tachin-r/Pyranometer_Over_engineering/Report_doc/image/thumb_power_switching.jpg

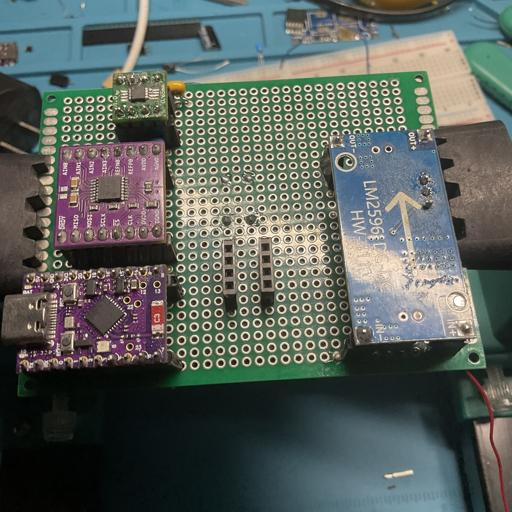
Report_doc/image/thumb_power_switching.jpg
