tachin-r/Pyranometer_Over_engineering/Report_doc/image/breadboard_real_photo.jpg

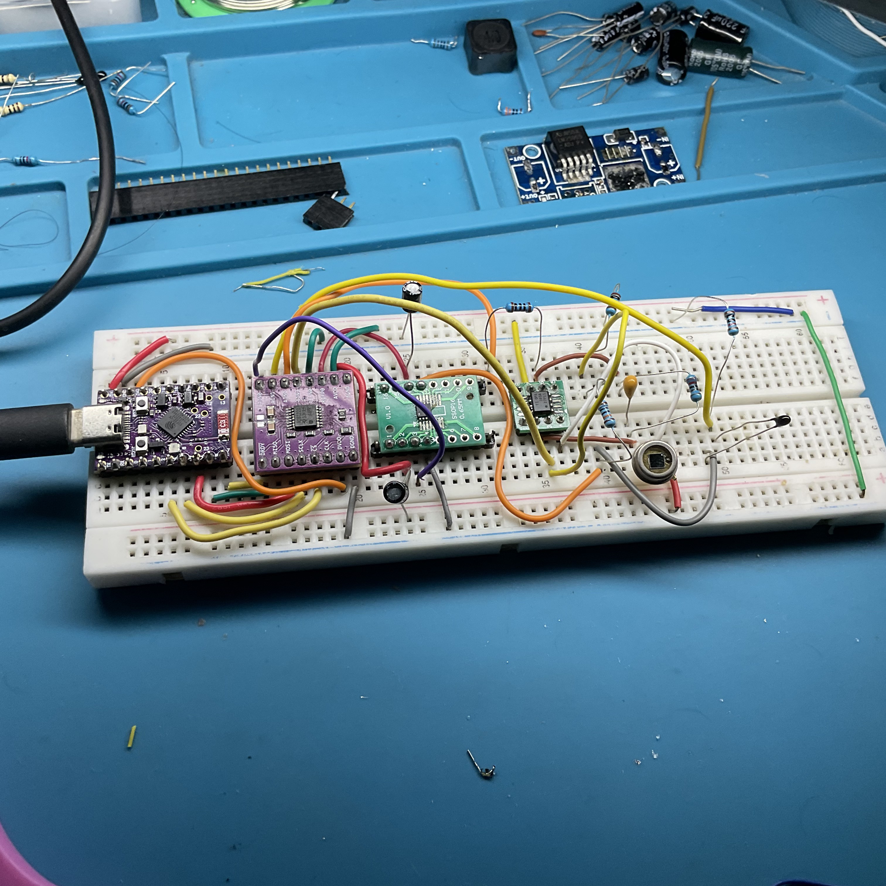
Report_doc/image/breadboard_real_photo.jpg
