tachin-r/Pyranometer_Over_engineering/README.md

# Pyranometer Over-engineering ☀️⚡

Modular High-Precision Pyranometer KiCad Hardware Project.

---

## 📑 Project Structure & Interactive Online Viewers

Explore the schematics and PCB layouts interactively directly in your browser powered by **KiCanvas** (no installation required):

| Board / Module | Description | Interactive Project (Schematic + PCB) | Schematic Only | PCB Only |
| :--- | :--- | :---: | :---: | :---: |
| **L1_Analog** | Analog Front-End & Sensor Interface | [🚀 Open L1 Board](https://kicanvas.org/?github=https://github.com/tachin-r/Pyranometer_Over_engineering/tree/main/L1_Analog) | [🔍 Schematic](https://kicanvas.org/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) | [🔍 PCB](https://kicanvas.org/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) |
| **L2_MCU** | Microcontroller Processing Board | [🚀 Open L2 Board](https://kicanvas.org/?github=https://github.com/tachin-r/Pyranometer_Over_engineering/tree/main/L2_MCU) | [🔍 Schematic](https://kicanvas.org/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) | [🔍 PCB](https://kicanvas.org/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) |
| **L3_Switching** | Power Management & Switching Regulators | [🚀 Open L3 Board](https://kicanvas.org/?github=https://github.com/tachin-r/Pyranometer_Over_engineering/tree/main/L3_Switching) | [🔍 Schematic](https://kicanvas.org/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) | [🔍 PCB](https://kicanvas.org/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) |
| **LM2596 HW-411** | Reverse-Engineered Buck Converter Module | [🚀 Open LM2596](https://kicanvas.org/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) | [🔍 Schematic](https://kicanvas.org/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) | [🔍 PCB](https://kicanvas.org/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) |

---

## 🛠️ Boards Overview

### 1. `L1_Analog` (Sensor Front-End)
* Precision Analog Signal Conditioning stage designed for low-noise measurement of solar irradiance sensor signals (Pyranometer Thermopile / Photodiode).

### 2. `L2_MCU` (Processing & Control)
* Primary microcontroller board responsible for high-resolution ADC sampling, calibration algorithms, digital filtering, and telemetry communication.

### 3. `L3_Switching` (Power Distribution)
* Power supply unit (PSU) providing efficient switching regulation, clean power rail generation, and noise filtering for sensitive analog circuitry.

### 4. `reverse_component/LM2596_HW411`
* Reverse-engineered KiCad schematic and PCB layout of the common LM2596 HW-411 DC-DC step-down converter module, used for reference, testing, and validation.

---

## 🚀 Working with KiCad

This project is organized as a **modular multi-board system**:
* Each sub-directory contains its own standalone KiCad project file (`.kicad_pro`).
* To view or edit a board, open the corresponding `.kicad_pro` file inside its respective directory.

---

## 🔬 Capstone Documentation & Laboratory Calibration

* **[☀️ Solar Simulator Preparation & Contact Guide](file:///c:/Users/usEr/Documents/KiCad/10.0/projects/Pyranometer_Over_engineering/Report_doc/SOLAR_SIMULATOR_GUIDE.md)**: Contact templates, technical phone checklists, and procedures for using the **Solar Light XPS-300** at ATTAC / Nano Central Lab (Building 55, 3rd Floor).
* **[📷 Perfboard Photo & Figure Insertion Guide](file:///c:/Users/usEr/Documents/KiCad/10.0/projects/Pyranometer_Over_engineering/Report_doc/PHOTO_GUIDE_PERFBOARD.md)**: Complete image checklist and tips for inserting hardware photos into the report.
* **[📄 Capstone Progress Report V2 (.docx)](file:///c:/Users/usEr/Documents/KiCad/10.0/projects/Pyranometer_Over_engineering/Report_doc/69_IoT_Project1_Report_V2.docx)**: Official 5-chapter thesis report draft formatted to KMITL guidelines.
