tachin-r/Pyranometer_Over_engineering/SMD_EP_Adapter_Business_Plan.md

# 💡 แผนธุรกิจและการพัฒนาสินค้า: บอร์ดแปลงขา SMD แบบมีแผ่นระบายความร้อน/กราวด์ใต้ท้องชิป (Precision SMD-EP Breakout Adapter Series)

> **ที่มาของไอเดีย (Real-World Pain Point):**
> จากการทำโปรเจกต์ **Engineering Pyranometer** แล้วพบปัญหาคลาสสิกเมื่อนำชิปเกรดเครื่องมือวัดของ Texas Instruments (`TPS7A4901DGNR` ตัวถัง `MSOP-8 PowerPAD`) ไปวางบนบอร์ดแปลงขา `MSOP-8` ทั่วไปที่มีขายในไทย ซึ่ง **ไม่มีแผ่นทองแดงตรงกลาง (Exposed Pad / Pin 9)** ส่งผลให้กราวด์ของฐานซิลิคอน (Die Substrate) ลอย และแรงดันอ้างอิงภายในตกเหลือครึ่งเดียว (`0.625 V` แทนที่จะเป็น `1.185 V`) ครั้นจะสั่งซื้อบอร์ดแปลงขาเฉพาะทางจากต่างประเทศ (เช่น Chip Quik / Proto-Advantage) ก็มีราคาสูงถึงชิ้นละ **230–250 บาท ($6.69)** ในขณะที่ตลาดในไทยยังไม่มีใครทำบอร์ดแปลงขาตระกูล `Exposed Pad (EP)` ออกมาขายเลย

---

## 🎯 1. จุดขายหลักที่เหนือกว่าบอร์ดทั่วไปในตลาด (Unique Selling Points)

1. **บัดกรีแผ่นใต้ท้องชิป (`EP` / `PowerPAD`) ได้ด้วยหัวแร้งธรรมดา (No Hot-Air Required):**
   * ออกแบบรูชุบทองแดงทะลุขนาดใหญ่ (**Center Solder Via Ø `1.0 – 1.2 mm`**) ตรงกลางแผ่น `Exposed Pad`
   * ผู้ใช้เพียงวางชิปและบัดกรีขารอบนอกตามปกติ แล้วพลิกด้านหลังบอร์ดเอาหัวแร้งจี้เติมตะกั่วลงในรูตรงกลาง ตะกั่วจะซึมขึ้นไปยึดติดกับท้องชิป (ขา 9) แน่นสนิทโดยไม่ต้องใช้เครื่องเป่าลมร้อน
2. **มี Solder Jumper เลือกต่อลง `GND` ได้ในหยดเดียว:**
   * ด้านหลังบอร์ดมีจุดแตะตะกั่วเชื่อมแผ่น `EP` เข้ากับขามาตรฐานที่เป็น `GND` (เช่น ขา 4 สำหรับตระกูล LDO/Op-Amp) หรือจะแยกออกเป็นขา Pin ที่ 9 สำหรับเสียบลงเบรดบอร์ดโดยตรงก็ได้
3. **มีจุดวางตัวเก็บประจุ Bypass (`0805`) ชิดขาชิปบนตัวบอร์ดแปลงขา:**
   * แก้ปัญหาสายยาวบนเบรดบอร์ดที่ทำให้วงจรความละเอียดสูงเกิดการแกว่ง (Oscillation) หรือสัญญาณรบกวนสูง โดยเตรียม Pad ขนาด `0805` ไว้ชิดขาไฟเลี้ยง (`IN`/`VDD` และ `OUT` เทียบกับแผ่น `EP GND`)
4. **ผิวชุบทอง (`ENIG` - Electroless Nickel Immersion Gold) หรือสีบอร์ดเกรดพรีเมียม (สีดำด้าน / สีน้ำเงินเข้ม):**
   * ช่วยให้แผ่นเรียบสนิท วางชิปที่มีระยะห่างขาแคบ (`0.5 mm` – `0.65 mm`) ได้ง่าย ไม่กระดก และเก็บไว้ได้นานโดยไม่ขึ้นออกไซด์

---

## 📦 2. รายการสินค้าที่ควรทำออกขาย (Product Lineup — 5 รุ่นยอดฮิต)

| ลำดับ | ชื่อรุ่นบอร์ดแปลงขา | ตัวถังชิปที่รองรับ | ตัวอย่างชิปยอดนิยมที่ใช้ตัวถังนี้ | ราคาขายแนะนำ (บาท/ชิ้น) |
| :---: | :--- | :--- | :--- | :---: |
| **1** | **MSOP-8-EP / HVSSOP-8 Pro Adapter** | `MSOP-8` / `DGNR` (`0.65 mm` pitch + Center Pad) | `TPS7A4901`, `TPS7A3001`, `TPS7A47`, `OPA2188`, `INA826` | **35 – 49 ฿** |
| **2** | **SOIC-8-EP (PowerSOIC-8) Pro Adapter** | `SOIC-8` (`1.27 mm` pitch + Center Pad) | `TPS5430`, `TPS54331` (Buck Converter), ชิปตระกูล H-Bridge / Motor Driver | **29 – 39 ฿** |
| **3** | **TSSOP-14-EP / TSSOP-16-EP Pro Adapter** | `TSSOP-14 / 16` (`0.65 mm` pitch + Center Pad) | ชิป Multi-channel ADC/DAC, LED Driver, Audio Amp, Power Management | **45 – 59 ฿** |
| **4** | **WSON-8 / DFN-8 (`3x3 mm` & `2x2 mm`) Adapter** | `WSON-8` / `DFN-8` (ไร้ขา มีแผ่น EP ตรงกลาง) | `TPS7A4901DRB`, `TPS7A20`, เซนเซอร์ I2C และ LDO ยุคใหม่ | **45 – 59 ฿** |
| **5** | **QFN-16 / QFN-20 / QFN-24 (`3x3` & `4x4 mm`)** | `QFN` พร้อมรูบัดกรีตรงกลางแผ่น `EP` | ชิปไมโครคอนโทรลเลอร์, RF Transceiver, IMU, PMIC | **59 – 89 ฿** |

---

## 💰 3. โครงสร้างต้นทุนและกำไร (Unit Economics)

* **ขนาดต่อ 1 ชิ้นย่อย (Sub-board):** ประมาณ `10.16 mm × 12.70 mm` (เสียบลงเบรดบอร์ด 2.54 mm มาตรฐานได้พอดี)
* **การจัดวางลงแผงใหญ่ (Panelization `100 × 100 mm`):**
  * 1 แผงใหญ่ (`100 × 100 mm`) สามารถเรียงบอร์ดย่อยพร้อมทำร่องหัก (`V-Cut`) ได้ประมาณ **72 ชิ้นต่อแผง**
  * สั่งผลิตขั้นต่ำ 5 แผง ได้บอร์ดย่อยทั้งหมด **`72 × 5 = 360 ชิ้น`**
* **ต้นทุนการผลิต (รวมค่าส่งจาก JLCPCB / PCBWay):**
  * แบบมาตรฐาน (HASL Lead-Free): ประมาณ `150 – 250 บาท` ต่อ 360 ชิ้น $\rightarrow$ **ต้นทุนเฉลี่ย ~`0.50 – 0.70 บาท/ชิ้น`**
  * แบบชุบทองพรีเมียม (`ENIG`): ประมาณ `600 – 800 บาท` ต่อ 360 ชิ้น $\rightarrow$ **ต้นทุนเฉลี่ย ~`1.80 – 2.20 บาท/ชิ้น`**
* **การจัดชุดขายเพิ่มมูลค่า (High-Margin Bundles):**
  1. **ชุดแผ่นเปล่า + ก้านขาทองเหลือง (Single Board + Pin Header):** ต้นทุน ~`3 บาท` $\rightarrow$ ขาย **`39 – 49 บาท`**
  2. **ชุด Lab Starter Pack (แพ็ก 5 ชิ้น + ก้านขา + C Bypass `0.1uF / 10uF`):** ต้นทุน ~`18 บาท` $\rightarrow$ ขาย **`149 – 179 บาท`**
  3. **ชุดบัดกรีชิปแท้พร้อมใช้งาน (Pre-Soldered Precision Module):** เช่น บัดกรี `TPS7A4901DGNR` หรือ `REF5045` พร้อมใช้งานเสียบเบรดบอร์ดได้ทันที สำหรับห้องแล็บและโปรเจกต์จบ $\rightarrow$ อัปราคาเพิ่มจากค่าชิปได้อีก **`150 – 250 บาท/โมดูล`**

---

## 🛠️ 4. ขั้นตอนการลงมือทำใน KiCad (Action Checklist)

- [ ] **Step 1:** สร้างโปรเจกต์ KiCad สำหรับบอร์ดรุ่นแรก **`MSOP-8-EP (DGNR) to DIP-8/9 Pro Adapter`**
- [ ] **Step 2:** วาง Footprint `MSOP-8-1EP_3x3mm_P0.65mm` โดยเจาะรู Via ตรงกลางแผ่น `EP` ขนาดรูสว่าน `1.0 mm` (เพื่อให้จี้ตะกั่วจากด้านหลังบอร์ดทะลุขึ้นไปติดท้องชิปได้ด้วยหัวแร้ง)
- [ ] **Step 3:** ด้านหลังบอร์ด (`B.Cu`) วาง Solder Jumper (`JP1`) เชื่อมระหว่างแผ่น `EP` กับขา 4 (`GND`) และวาง Pad สำหรับตัวเก็บประจุ `0805` คร่อมขาไฟเลี้ยง
- [ ] **Step 4:** สกรีนชื่อขาและทิศทางขา 1 (`Pin 1 Dot`) ให้ใหญ่และชัดเจนทั้งด้านบนและด้านล่าง
- [ ] **Step 5:** ใช้ปลั๊กอิน `KiKit` หรือสั่ง Panelize `V-Cut` ขนาด `100 × 100 mm` ส่งผลิตล็อตแรก
- [ ] **Step 6:** ถ่ายรูปคู่กับเคสศึกษาจริง (*"แก้ปัญหา TPS7A4901 ไฟออกครึ่งเดียวเพราะขา 9 ลอย"*) ลงขายใน Shopee / Lazada และโพสต์ให้ความรู้ในกลุ่มอิเล็กทรอนิกส์ไทย
