tachin-r/Pyranometer_Over_engineering/Report_doc/69_IoT_Project1_Report_V2.docx

การพัฒนาระบบวัดการแผ่รังสีแสงอาทิตย์ความแม่นยำสูง

DEVELOPMENT OF SOLAR IRRADIANCE MEASUREMENT SYSTEM

นายเตชินท์ รัฐวงษา รหัสนักศึกษา 66010296
นายณัฐพัชร์ รัตนนวงศ์ รหัสนักศึกษา 66010256
นายพีรวิช เฉลิมเกียรติ รหัสนักศึกษา 66010591

รายงานความก้าวหน้าโครงงานปริญญานิพนธ์ 1 นี้เป็นส่วนหนึ่งของการศึกษาตามหลักสูตร
หลักสูตรสองปริญญา (Dual Degree):
วิศวกรรมศาสตรบัณฑิต (วิศวกรรมระบบไอโอทีและสารสนเทศ)
และ วิทยาศาสตรบัณฑิต (ฟิสิกส์อุตสาหกรรม)
คณะวิศวกรรมศาสตร์
สถาบันเทคโนโลยีพระจอมเกล้าเจ้าคุณทหารลาดกระบัง
ปีการศึกษา 2569

DEVELOPMENT OF SOLAR IRRADIANCE
MEASUREMENT SYSTEM

MR. TECHIN RATTAWONGSA STUDENT ID 66010296
MR. NATTAPAT RATANANWONG STUDENT ID 66010256
MR. PEERAWICH CHALOEMKIAT STUDENT ID 66010591

A CAPSTONE PROJECT 1 PROGRESS REPORT SUBMITTED IN PARTIAL FULFILLMENT
OF THE REQUIREMENTS FOR THE DUAL DEGREE OF
BACHELOR OF ENGINEERING IN IOT SYSTEM AND INFORMATION ENGINEERING AND
BACHELOR OF SCIENCE IN INDUSTRIAL PHYSICS
SCHOOL OF ENGINEERING
KING MONGKUT'S INSTITUTE OF TECHNOLOGY LADKRABANG
ACADEMIC YEAR 2026

ใบรับรองรายงานความก้าวหน้าโครงงานปริญญานิพนธ์ 1

หัวข้อปริญญานิพนธ์ | การพัฒนาระบบวัดการแผ่รังสีแสงอาทิตย์ความแม่นยำสูง
Thesis Title | Development of Solar Irradiance Measurement System
ชื่อนักศึกษา | นาย เตชินท์ รัฐวงษา รหัสนักศึกษา 66010296 นาย ณัฐพัชร์ รัตนนวงศ์ รหัสนักศึกษา 66010256 นาย พีรวิช เฉลิมเกียรติ รหัสนักศึกษา 66010591
ระดับปริญญา | วิศวกรรมศาสตรบัณฑิตและวิทยาศาสตรบัณฑิต (หลักสูตรสองปริญญา)
สาขาวิชา | วิศวกรรมระบบไอโอทีและสารสนเทศ และ ฟิสิกส์อุตสาหกรรม
ปีการศึกษา | 2569
อาจารย์ที่ปรึกษา | ผศ.ดร.ธนวิชญ์ อนวงค์พินิจ ผศ.ดร.ประธาน บูรณศิริ

คณะวิศวกรรมศาสตร์ สถาบันเทคโนโลยีพระจอมเกล้าเจ้าคุณทหารลาดกระบัง อนุมัติให้รายงานความก้าวหน้านี้เป็นส่วนหนึ่งของรายวิชา 01236269 - IoT AND INFORMATION CAPSTONE PROJECT 1 ตามหลักสูตรปริญญาวิศวกรรมศาสตรบัณฑิต (วิศวกรรมระบบไอโอทีและสารสนเทศ) และวิทยาศาสตรบัณฑิต (ฟิสิกส์อุตสาหกรรม) ประจำปีการศึกษา 2569

คณะกรรมการสอบ | ลายมือชื่อ
ประธานกรรมการสอบ | ....................................................
กรรมการ | ....................................................
กรรมการ | ....................................................
กรรมการและอาจารย์ที่ปรึกษา (ผศ.ดร.ธนวิชญ์ อนวงค์พินิจ) | ....................................................
กรรมการและอาจารย์ที่ปรึกษาร่วม (ผศ.ดร.ประธาน บูรณศิริ) | ....................................................

บทคัดย่อ

รายงานความก้าวหน้าโครงงานปริญญานิพนธ์ 1 ฉบับนี้นำเสนอการวิจัย ออกแบบ และสร้างต้นแบบระบบวัดการแผ่รังสีแสงอาทิตย์ความแม่นยำสูง (High-Precision Solar Irradiance Measurement System) โดยมุ่งเน้นการแก้ปัญหาความคลาดเคลื่อนทางทัศนศาสตร์เชิงมุม (Cosine Error) และเสถียรภาพของวงจรตรวจวัดสัญญาณแอนะล็อกความละเอียดสูง ในขั้นแรกได้ทำการวิเคราะห์เปรียบเทียบเซนเซอร์โฟโตไดโอดชนิดซิลิคอนระหว่างรุ่น BPX 61 (ตัวถังโลหะ TO-39) และรุ่น BPW 34 (ตัวถังพลาสติกแบนราบ) ซึ่งพบว่าทั้งสองรุ่นใช้ชิปซิลิคอน (Silicon Die) ขนาดเดียวกันคือ 2.65 x 2.65 mm² (พื้นที่รับแสง 7.02 mm²) และมีคุณสมบัติทางไฟฟ้าเหมือนกันทุกประการ แต่ผลจากการจำลองทางทัศนศาสตร์ (Optical Ray-tracing Simulation) พบข้อเท็จจริงสำคัญว่า เมื่อจำลองเฉพาะกระป๋องเปล่าของ BPX 61 ขอบกระป๋องจะตัดแสงที่มุม 62 องศาตรงตามสเปก แต่เมื่อใส่กระจกหน้าต่างกระจก Schott 8250 การหักเหของแสงทำให้ขอบกระป๋องบังแสงเร็วขึ้นอย่างรุนแรงจนเกิดจุดตัดแสงตั้งแต่ 44 องศา โครงงานจึงเลือกใช้เซนเซอร์ BPW 34 ที่มีระนาบรับแสงแบนราบ ร่วมกับการติดตั้งกระจกแซฟไฟร์ (Sapphire Optical Window) เพื่อป้องกันรังสี UV และทนทานต่อรอยขีดข่วนกลางแจ้ง

ในภาคฮาร์ดแวร์ ได้ทำการต่อวงจรทดสอบขั้นแรกบน Breadboard ร่วมกับชิปแปลงสัญญาณ 24-bit Delta-Sigma ADC (ADS1220), แหล่งจ่ายแรงดันอ้างอิงความแม่นยำสูง (REF5045) และหัววัดอุณหภูมิ NTC Thermistor ซึ่งสามารถอ่านค่าสัญญาณจริงจากสภาวะแสงต่าง ๆ (ปิดไฟ, แสงขาวสว่างสุด, แสงส้มสว่างสุด, และแสงส้ม+ขาว) ผ่านพอร์ต Serial ได้สำเร็จ แต่ตรวจพบประเด็นเสถียรภาพของแรงดันอ้างอิง REF5045 อันเนื่องมาจากตัวเก็บประจุโหลดที่ใช้อยู่มีค่าความต้านทานอนุกรมสมมูล (ESR) สูงเกินเกณฑ์มาตรฐาน คณะผู้จัดทำจึงตัดสินใจรอดูตัวเก็บประจุชนิด Low-ESR Ceramic ที่สั่งซื้อไป (กำหนดส่งมอบ 30 ต.ค. 2569) ก่อนทำการบัดกรีลงแผงวงจรอเนกประสงค์ (Perfboard) ในคราวเดียว นอกจากนี้ ผลซิมที่พบว่าการมีกระจกทำให้ค่าเพี้ยนอย่างมีนัยสำคัญ ทำให้คณะผู้จัดทำได้ออกแบบระเบียบวิธีการทดลองจริงร่วมกับภาควิชาฟิสิกส์ คณะวิทยาศาสตร์ ได้แก่ การทดสอบการส่องผ่านสเปกตรัม (UV-Vis-NIR Spectrophotometer) และการทดสอบการตอบสนองเชิงมุมบนแท่นหมุนโกนิโอมิเตอร์ เพื่อนำไปปฏิบัติการจริงในการสอบเทียบระยะถัดไป

ABSTRACT

This Capstone Project 1 progress report presents the research, design, and prototyping of a high-precision solar irradiance measurement system, focusing on mitigating directional cosine error and front-end instrumentation noise. An in-depth comparative analysis between the BPX 61 (TO-39 metal can) and BPW 34 (flat clear plastic package) silicon photodiodes revealed that both devices share the exact same silicon die (2.65 x 2.65 mm², 7.02 mm² active area) with identical optoelectronic characteristics. However, optical ray-tracing simulations revealed that while the bare TO-39 can exhibits an optical cutoff at ~62°, introducing the Schott 8250 glass window severely accelerates rim shadowing due to refractive bending, causing a premature optical cutoff at 44°. Consequently, the flat BPW 34 package was selected and coupled with an optical-grade sapphire window for enhanced outdoor durability and UV protection.

The signal acquisition circuit was prototyped and validated on a breadboard, integrating a 24-bit delta-sigma ADC (TI ADS1220), a precision voltage reference (REF5045), and an NTC thermistor. Successful live data logging was demonstrated across various lighting conditions (dark, full white LED, full orange LED, and combined spectrum). Debugging identified reference voltage instability caused by excessive Equivalent Series Resistance (ESR) in the output decoupling capacitor, leading to the strategic decision to await low-ESR ceramic capacitors before executing the permanent perfboard assembly. Furthermore, because simulations demonstrated that optical windows introduce non-ideal refractive and reflective shifts, two rigorous experimental protocols were formulated in collaboration with the Faculty of Science: (1) UV-Vis-NIR spectrophotometer transmission testing, and (2) goniometric angular response verification, establishing a robust empirical foundation for Capstone Project 2.

กิตติกรรมประกาศ

คณะผู้ดำเนินโครงงานขอกราบขอบพระคุณ ผศ.ดร.ธนวิชญ์ อนวงค์พินิจ อาจารย์ที่ปรึกษาหลัก และ ผศ.ดร.ประธาน บูรณศิริ อาจารย์ที่ปรึกษาร่วม ตลอดจนคณาจารย์ภาควิชาวิศวกรรมระบบไอโอทีและสารสนเทศ คณะวิศวกรรมศาสตร์ และภาควิชาฟิสิกส์ คณะวิทยาศาสตร์ สถาบันเทคโนโลยีพระจอมเกล้าเจ้าคุณทหารลาดกระบัง ที่ได้กรุณาถ่ายทอดองค์ความรู้ ให้คำแนะนำเชิงวิชาการอย่างลึกซึ้ง ทั้งในด้านการออกแบบวงจรอิเล็กทรอนิกส์ความแม่นยำสูงและการสนับสนุนเครื่องมือวัดทางทัศนศาสตร์ระดับห้องปฏิบัติการ

ขอขอบคุณคณาจารย์และเจ้าหน้าที่ห้องปฏิบัติการทัศนศาสตร์ ภาควิชาฟิสิกส์ คณะวิทยาศาสตร์ สจล. ที่ได้ให้ความอนุเคราะห์ในการเปิดให้ยืมใช้เครื่องตรวจวัดสเปกตรัม Vernier LabQuest 2 และอุปกรณ์ชุดแท่นหมุนวัดองศา ตลอดจนให้คำปรึกษาในการออกแบบระเบียบวิธีการทดลองเพื่อประเมินคุณลักษณะทางแสงของเซนเซอร์และกระจกแซฟไฟร์ในโครงงานนี้

คณะผู้จัดทำโครงงาน
นายเตชินท์ รัฐวงษา
นายณัฐพัชร์ รัตนนวงศ์
นายพีรวิช เฉลิมเกียรติ

สารบัญ

เรื่อง หน้า

บทคัดย่อภาษาไทย i

บทคัดย่อภาษาอังกฤษ (ABSTRACT) ii

กิตติกรรมประกาศ iii

สารบัญ iv

สารบัญตาราง vi

สารบัญรูป vii

บทที่ 1 บทนำ 1

1.1 ความเป็นมาและความสำคัญของปัญหา 1

1.2 วัตถุประสงค์ของโครงงาน 2

1.3 ขอบเขตของโครงงาน (Project 1) 3

1.4 ประโยชน์ที่คาดว่าจะได้รับ 3

1.5 แผนการดำเนินงานโครงงาน 4

บทที่ 2 ทฤษฎีและงานวิจัยที่เกี่ยวข้อง 5

2.1 มาตรฐานการวัดรังสีดวงอาทิตย์ (ISO 9060:2018) 5

2.2 การวิเคราะห์เปรียบเทียบชิปเซนเซอร์ BPX 61 และ BPW 34 7

2.3 ทฤษฎีโฟโตไดโอดและวงจรขยายกระแสแสง (Photodiode & TIA Theory) 10

2.4 คุณสมบัติทางแสงของกระจกแซฟไฟร์ (Sapphire Optical Window) 13

2.5 ไอซีแปลงสัญญาณแอนะล็อกเป็นดิจิทัล 24 บิต (ADS1220) 15

2.6 แหล่งจ่ายแรงดันอ้างอิงความแม่นยำสูง (REF5045) และข้อกำหนดตัวเก็บประจุ 17

บทที่ 3 การออกแบบระบบ การสร้างต้นแบบ การจำลอง และระเบียบวิธีวิจัย 16

3.1 สถาปัตยกรรมระบบวัดและผังวงจรรวม 16

3.2 การสร้างต้นแบบและการทดสอบจริงบน Breadboard 18

3.3 ผลการจำลองทางทัศนศาสตร์และการค้นพบความผิดเพี้ยนจากกระจกหน้าต่าง 22

3.4 การออกแบบข้อเสนอระเบียบวิธีการทดลองจริงทางทัศนศาสตร์ 26

3.5 สถานะปัจจุบันและการออกแบบแผ่นวงจรพิมพ์ 4 เลเยอร์สู่การผลิตจริง 29

เอกสารอ้างอิง 31

ภาคผนวก 33

สารบัญตาราง

ตารางที่ หน้า

ตารางที่ 1.1 แผนการดำเนินงานและกิจกรรมโครงงานตลอดปีการศึกษา 4

ตารางที่ 2.1 เกณฑ์มาตรฐานการจำแนกประเภท Pyranometer ตาม ISO 9060:2018 6

ตารางที่ 2.2 การเปรียบเทียบพารามิเตอร์ทางเทคนิคระหว่าง OSRAM BPX 61 กับ BPW 34 8

ตารางที่ 3.1 ตารางกำหนดช่องสัญญาณอินพุตมัลติเพล็กเซอร์ (Input MUX) ของไอซี ADS1220 17

ตารางที่ 3.2 ตารางกำหนดการเชื่อมต่อขาสัญญาณระหว่างไมโครคอนโทรลเลอร์ ESP32-C6 Super Mini กับ ADS1220 18

ตารางที่ 3.3 ข้อมูลการอ่านค่าแรงดันจริงบน Breadboard ภายใต้สภาวะแสงต่างๆ 20

ตารางที่ 3.4 ตารางเปรียบเทียบแรงดันอ้างอิง REF5045 ระหว่างแหล่งจ่าย USB และแหล่งจ่ายสวิตชิ่ง 5.2 V 22

ตารางที่ 3.5 ตารางเปรียบเทียบผลการจำลองเชิงมุม: BPX 61 vs BPW 34 26

สารบัญรูป

รูปที่ หน้า

รูปที่ 2.1 คุณลักษณะการตอบสนองต่อทิศทาง (Directional Polar Plot) ของ BPX 61 9

รูปที่ 2.2 มิติและโครงสร้างกายภาพตัดขวางของตัวถัง TO-39 (BPX 61) เทียบกับ BPW 34 9

รูปที่ 2.3 คุณลักษณะกราฟกระแส-แรงดัน (I-V Curves) ของโฟโตไดโอดและโหมดการทำงาน 11

รูปที่ 2.4 สถาปัตยกรรมวงจรขยายกระแสแสงแบบ Transimpedance Amplifier (TIA) ด้วยไอซี OPA388 12

รูปที่ 2.5 กราฟการส่องผ่านทางแสงตามทฤษฎีของผลึกแซฟไฟร์ (Sapphire Transmission) 14

รูปที่ 2.6 บล็อกไดอะแกรมโครงสร้างวงจรภายในของไอซี 24-bit ADC (ADS1220) 16

รูปที่ 2.7 วงจรการต่อใช้งาน REF5045 และข้อกำหนดตัวเก็บประจุโหลด Low-ESR 18

รูปที่ 3.1 บล็อกไดอะแกรมระบบวัดไพราโนมิเตอร์ต้นแบบ 16

รูปที่ 3.2 📸 ภาพถ่ายการทดสอบวงจรต้นแบบจริงบน Breadboard 19

รูปที่ 3.3 ภาพจำลองโมเดล 3D CAD ส่วนประกอบของเซนเซอร์ BPX 61 23

รูปที่ 3.4 ผลการจำลองการตอบสนองเชิงมุมของ BPX 61: กรณีไม่มีกระจก เทียบกับ มีกระจก 24

รูปที่ 3.5 ผลการจำลองการตอบสนองเชิงมุมและ Heatmap ของ BPW 34 พร้อมการประเมิน ISO 9060 26

รูปที่ 3.6 หน้าจอแสดงผลการวัดสเปกตรัมของชุด Vernier LabQuest 2 ในห้องปฏิบัติการฟิสิกส์ 27

รูปที่ 3.7 แบบจำลองชุดแท่นหมุนวัดการตอบสนองเชิงมุมพร้อมข้อเสนอชุดกำเนิดแสงแสวงเครื่อง 28

บทที่ 1

บทนำ
(Introduction)

1.1 ความเป็นมาและความสำคัญของปัญหา

ข้อมูลความเข้มการแผ่รังสีแสงอาทิตย์รวมในแนวราบ (Global Horizontal Irradiance: GHI, หน่วย W/m²) เป็นตัวแปรทางฟิสิกส์ที่มีความสำคัญอย่างยิ่งต่อการประเมินประสิทธิภาพและตรวจวัดสุขภาพของโรงไฟฟ้าพลังงานแสงอาทิตย์ (Photovoltaic System Performance Ratio: PR) ตลอดจนการศึกษาอุตุนิยมวิทยาพลังงานแสงอาทิตย์ เครื่องมือวัดรังสีดวงอาทิตย์ (Pyranometer) เกรดมาตรฐานอ้างอิงสากลตาม ISO 9060:2018 เช่น ระดับ Class A มักใช้เทคโนโลยีหัววัดแบบเทอร์โมไพล์ (Thermopile) และครอบด้วยโดมแก้วออปติคอลคู่เจียระไนความแม่นยำสูง ซึ่งมีราคาจำหน่ายสูงมาก (มากกว่า 80,000 ถึง 150,000 บาทต่อเครื่อง) ทำให้เป็นอุปสรรคสำคัญในการติดตั้งสถานีตรวจวัดแบบกระจายตัวหนาแน่น (Distributed Sensor Network)

การพัฒนาไพราโนมิเตอร์ราคาประหยัดโดยใช้เซนเซอร์สารกึ่งตัวนำชนิดซิลิคอนโฟโตไดโอด (Silicon Photodiode) เป็นแนวทางที่ได้รับความสนใจอย่างกว้างขวางเนื่องจากมีเวลาตอบสนองรวดเร็วและให้สัญญาณไฟฟ้าที่ชัดเจน อย่างไรก็ตาม การนำโฟโตไดโอดมาสร้างเป็นไพราโนมิเตอร์ต้องเผชิญกับความท้าทายหลัก 2 ประการ ได้แก่: (1) ความคลาดเคลื่อนเชิงมุมตกกระทบ (Cosine Error) ซึ่งเกิดจากลักษณะทางกายภาพของโครงสร้างตัวถังและการหักเหของกระจกหน้าต่าง และ (2) ความเสถียรและความเงียบของวงจรขยายสัญญาณ ซึ่งต้องการวงจรแปลงสัญญาณดิจิทัลที่มีความละเอียดสูงและแหล่งจ่ายแรงดันอ้างอิงที่นิ่งสนิท

โครงงานนี้จึงมุ่งวิจัยและพัฒนาต้นแบบระบบวัดการแผ่รังสีแสงอาทิตย์ความแม่นยำสูง โดยทำการวิเคราะห์เปรียบเทียบชิปเซนเซอร์ จำลองพฤติกรรมเชิงแสงเพื่อศึกษาผลกระทบของการหักเหแสงผ่านกระจกหน้าต่าง สร้างและทดสอบวงจรอ่านสัญญาณความละเอียด 24 บิตบน Breadboard และออกแบบระเบียบวิธีการทดลองทางทัศนศาสตร์ร่วมกับภาควิชาฟิสิกส์ คณะวิทยาศาสตร์ เพื่อเตรียมการสอบเทียบตามมาตรฐานสากลต่อไป

1.2 วัตถุประสงค์ของโครงงาน

1. การคัดเลือกหัววัด: เพื่อศึกษาและวิเคราะห์เปรียบเทียบคุณลักษณะทางแสงและกายภาพระหว่างโฟโตไดโอดรุ่น BPX 61 และ BPW 34 ในการประยุกต์ใช้งานเป็นหัววัดไพราโนมิเตอร์

2. การสร้างและดีบักวงจร: เพื่อออกแบบ สร้าง และทดสอบวงจรอ่านสัญญาณต้นแบบบน Breadboard โดยใช้ตัวแปลงสัญญาณ 24-bit ADC (ADS1220) และวิเคราะห์เสถียรภาพของ REF5045 ต่อค่า ESR ของตัวเก็บประจุ

3. การจำลองทางทัศนศาสตร์: เพื่อจำลองพฤติกรรมทางทัศนศาสตร์เชิงมุม (Optical Ray-tracing Simulation) และวิเคราะห์ผลกระทบของโครงสร้างตัวถังและกระจกหน้าต่างต่อความคลาดเคลื่อนโคไซน์

4. การออกแบบการทดลอง: เพื่อออกแบบระเบียบวิธีการทดลองจริง (Experimental Protocols) สำหรับการวัดค่าการส่องผ่านสเปกตรัม (Spectrophotometer) และการวัดการตอบสนองเชิงมุมร่วมกับคณะวิทยาศาสตร์

1.3 ขอบเขตของโครงงาน (Capstone Project 1)

• การศึกษาและวิเคราะห์สเปกตรัมของโฟโตไดโอดซิลิคอนในช่วงความยาวคลื่น 400 ถึง 1,100 nm

• การออกแบบและประกอบวงจรทดสอบต้นแบบบน Breadboard พร้อมหัววัด NTC ชดเชยอุณหภูมิ และเก็บบันทึกข้อมูลผ่าน Serial Monitor ใน 4 สภาวะแสง

• การดีบักและวิเคราะห์เสถียรภาพแรงดันอ้างอิง 4.500 V (REF5045) ต่อค่า ESR ของตัวเก็บประจุโหลด เพื่อเตรียมการลงบอร์ด Perfboard

• การจำลองพฤติกรรมเชิงมุมตกกระทบ (0 ถึง 85 องศา) บนแบบจำลองเรขาคณิต 3 มิติของตัวถัง TO-39 (มีและไม่มีกระจก) เทียบกับ BPW 34

• การจัดทำคู่มือและระเบียบวิธีทดสอบ (Testing Protocols) 2 ชุด เพื่อใช้กับเครื่องมือวัดของภาควิชาฟิสิกส์ คณะวิทยาศาสตร์ สจล.

1.4 ประโยชน์ที่คาดว่าจะได้รับ

• ได้องค์ความรู้เชิงลึกเกี่ยวกับผลกระทบของการหักเหแสงผ่านกระจกหน้าต่างต่อคุณลักษณะการตอบสนองเชิงมุมของไพราโนมิเตอร์

• ได้ต้นแบบวงจรอ่านสัญญาณแอนะล็อกความละเอียดสูง 24 บิตบน Breadboard ที่ผ่านการทดสอบเก็บข้อมูลจริงและเข้าใจแนวทางการแก้ปัญหา ESR

• ได้กรอบระเบียบวิธีการทดลองทางทัศนศาสตร์ที่ชัดเจน พร้อมสำหรับการทดสอบและสอบเทียบจริงในโครงงาน 2

1.5 แผนการดำเนินงานโครงงาน

แผนการดำเนินงานโครงงาน Capstone Project 1 มีรายละเอียดขั้นตอนและผลสัมฤทธิ์ที่ส่งมอบดังระบุในตารางที่ 1.1

ตารางที่ 1.1 แผนการดำเนินงานและกิจกรรมโครงงานตลอดปีการศึกษา

ระยะเวลา | กิจกรรมและขั้นตอนการดำเนินงาน | ผลสัมฤทธิ์ (Deliverables)
เดือน 1–2 | ศึกษามาตรฐาน ISO 9060 และสเปกตรัมโฟโตไดโอด BPX 61 vs BPW 34 | ข้อสรุปการคัดเลือกเซนเซอร์และกระจกแซฟไฟร์
เดือน 3–4 | ต่อวงจรทดสอบบน Breadboard และตรวจพบปัญหา Leakage ขา Trim | วงจรแก้ปัญหา High-Z Node และ DNP C11
เดือน 5 | จำลอง Ray-tracing เงากระป๋อง TO-39 และพบการเบี่ยงเบนเมื่อใส่กระจก Schott | ผลซิมเปรียบเทียบ BPX 61 vs BPW 34
เดือน 6 | วิเคราะห์ปัญหาเสถียรภาพ REF5045 ต่อ ESR ของ C และสั่งซื้อ C Low-ESR | แนวทางแก้ไขวงจรและรอ C เพื่อลง Perfboard วันที่ 30 ต.ค.
เดือน 7 (ปัจจุบัน) | ประสานงานคณะวิทยาศาสตร์ และออกแบบระเบียบวิธีทดสอบ 2 ชุด | ข้อเสนอ Protocol การทดลอง และเล่มรายงาน Project 1

บทที่ 2

ทฤษฎีและงานวิจัยที่เกี่ยวข้อง
(Literature Review)

2.1 มาตรฐานการวัดรังสีดวงอาทิตย์ (ISO 9060:2018)

มาตรฐานสากล ISO 9060:2018 กำหนดเกณฑ์และคุณลักษณะเฉพาะของเครื่องวัดรังสีแสงอาทิตย์ (Pyranometer) โดยแบ่งชั้นคุณภาพออกเป็น Class A, Class B และ Class C ตามพารามิเตอร์สำคัญในตารางที่ 2.1 ซึ่งพารามิเตอร์ที่เป็นอุปสรรคสำคัญที่สุดในการออกแบบหัววัดแบบโซลิดสเตตคือ Directional Response (Cosine Error) ซึ่งมาตรฐานกำหนดให้มีความคลาดเคลื่อนไม่เกิน ±20 W/m² สำหรับ Class B และไม่เกิน ±10 W/m² สำหรับ Class A

ตารางที่ 2.1 เกณฑ์มาตรฐานการจำแนกประเภท Pyranometer ตาม ISO 9060:2018

พารามิเตอร์สมรรถนะ | Class A | Class B | Class C
เวลาการตอบสนอง (Response Time, 95%) | < 0.5 s | < 10 s | < 20 s
การเลื่อนวนจากอุณหภูมิ (Temperature Drift) | < ±1% | < ±2% | < ±4%
ความไม่เป็นเชิงเส้น (Non-linearity) | < ±0.2% | < ±0.5% | < ±1.0%
การตอบสนองต่อทิศทาง (Directional / Cosine Error) | < ±10 W/m² | < ±20 W/m² | < ±30 W/m²
ความไม่เสถียรต่อปี (Non-stability per year) | < ±0.5% | < ±1.0% | < ±1.5%

2.2 การวิเคราะห์เปรียบเทียบชิปเซนเซอร์ BPX 61 และ BPW 34

ในการเลือกเซนเซอร์ตรวจจับรังสีแสงอาทิตย์ ได้ทำการศึกษารายละเอียดจากเอกสารข้อมูลทางเทคนิค (Datasheet) ของผู้ผลิต ams-OSRAM ระหว่างรุ่น BPX 61 (Metal Can TO-39) และรุ่น BPW 34 (Flat Clear Plastic) ดังเปรียบเทียบในตารางที่ 2.2

ตารางที่ 2.2 การเปรียบเทียบพารามิเตอร์ทางเทคนิคระหว่าง OSRAM BPX 61 กับ BPW 34

พารามิเตอร์ทางเทคนิค | OSRAM BPX 61 | OSRAM BPW 34
ขนาดพื้นที่รับแสง (Radiant Sensitive Area) | 7.02 mm² | 7.02 mm² (ชิปตัวเดียวกัน)
ขนาดของชิปซิลิคอน (Dimensions of Active Chip) | 2.65 x 2.65 mm | 2.65 x 2.65 mm (ชิปตัวเดียวกัน)
ช่วงความยาวคลื่นตอบสนอง (Spectral Range) | 420 ... 1120 nm | 420 ... 1120 nm
ความยาวคลื่นที่ไวสูงสุด (Peak Wavelength) | 920 nm | 920 nm
ความไวของชิปที่ 850 nm (Spectral Sensitivity) | 0.62 A/W | 0.62 A/W
ความจุไฟฟ้าของรอยต่อ (Capacitance, V_R = 0V) | 72 pF | 72 pF
สัมประสิทธิ์อุณหภูมิ (TC_I) | +0.18 %/K | +0.18 %/K

จากข้อมูลเชิงเปรียบเทียบในตารางที่ 2.2 จะเห็นได้อย่างชัดเจนว่าทั้ง BPX 61 และ BPW 34 ใช้ชิปซิลิคอน (Silicon Die) เทคโนโลยีเดียวกันทุกประการ มีพื้นที่รับแสง 7.02 mm² เท่ากัน และมีพฤติกรรมทางสเปกตรัมเหมือนกัน แต่จุดที่แตกต่างกันอย่างสิ้นเชิงคือโครงสร้างตัวถังภายนอก (Packaging):

• BPX 61 บรรจุในตัวถังโลหะ TO-39 โดยชิปซิลิคอนถูกติดตั้งจมลึกลงไปในหลุมกระป๋องถึง 1.55 ถึง 1.75 mm ใต้กระจกหน้าต่างขนาดเส้นผ่านศูนย์กลาง 6.0 mm โครงสร้างหลุมนี้ทำให้เกิดการบดบังแสงเชิงมุมอย่างรุนแรง ดังที่ปรากฏในกราฟ Directional Characteristics ใน Datasheet (รูปที่ 2.1) ซึ่งสัญญาณแสงจะตกฮวบอย่างรวดเร็วที่มุมเกิน 60 องศา และถูกตัดแสงสิ้นเชิงที่ 70 องศา

• BPW 34 บรรจุในตัวถังพลาสติกใสแบบแบนราบ ผิวชิปอยู่ชิดระนาบผิวด้านหน้าโดยไม่มีขอบกระป๋องยกสูง ทำให้มีมุมรับแสงกว้างมาก (Half Angle ±60 องศา) และตอบสนองต่อแสงอาทิตย์ในมุมเอียงได้ใกล้เคียงกับกฎโคไซน์ตามธรรมชาติมากกว่า

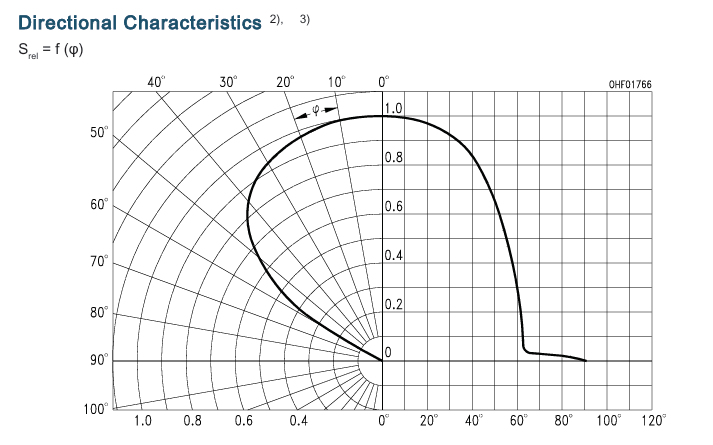
[picture p3: figure]
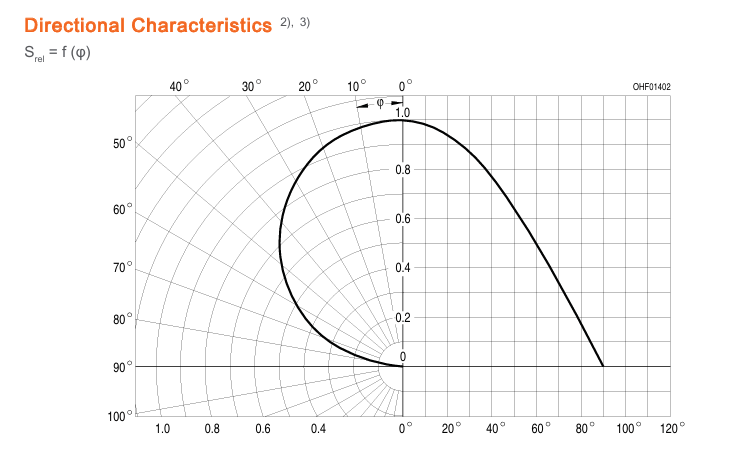
[picture p4: figure]

(ก) BPX 61 (TO-39 ขอบกระป๋องบังแสงที่มุมสูง) | (ข) BPW 34 (ตัวถังแบนราบ Half-angle ±60°)

รูปที่ 2.1 คุณลักษณะการตอบสนองต่อทิศทาง (Directional Polar Plot) จาก Datasheet

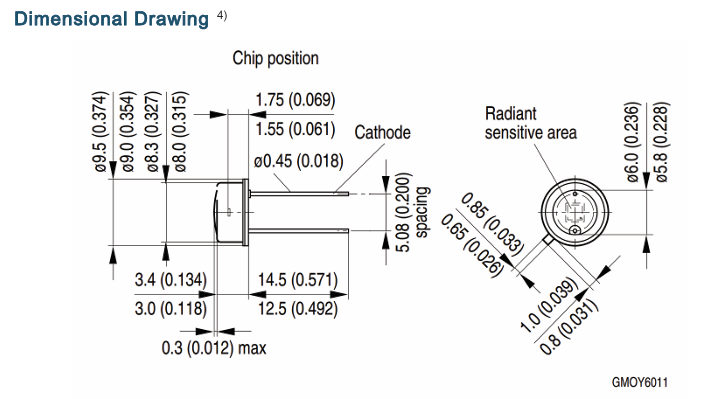
[picture p5: figure]
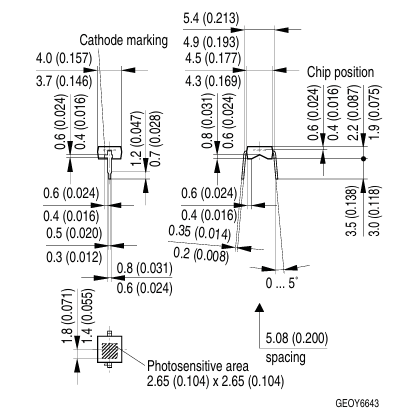
[picture p6: figure]

(ก) ตัวถัง TO-39 (BPX 61) ขอบลึก 1.55–1.75 มม. | (ข) ตัวถังแบนราบ (BPW 34) ชิปอยู่ชิดผิวหน้า

รูปที่ 2.2 มิติและโครงสร้างกายภาพของตัวถัง TO-39 (BPX 61) เทียบกับ BPW 34

2.3 ทฤษฎีโฟโตไดโอดและวงจรขยายกระแสแสง (Photodiode & TIA Theory)

การตรวจวัดรังสีดวงอาทิตย์ด้วยเซนเซอร์สารกึ่งตัวนำชนิดซิลิคอนโฟโตไดโอด (Silicon Photodiode) ต้องอาศัยความเข้าใจเชิงลึกเกี่ยวกับฟิสิกส์ของรอยต่อ p-n ภายใต้สภาวะแสงตกกระทบ และการออกแบบวงจรขยายสัญญาณฝั่งแอนะล็อกฟรอนต์เอนด์ (Analog Front-End: AFE) เพื่อให้ระบบมีความเป็นเชิงเส้น (Linearity) สูงสุด และมีสัญญาณรบกวนต่ำที่สุดตามข้อกำหนดของมาตรฐานเครื่องมือวัด

2.3.1 ฟิสิกส์ของโฟโตไดโอดและสมการกระแสโฟโตเคอร์เรนต์

เมื่อโฟตอนของแสงอาทิตย์ที่มีพลังงานสูงกว่าแถบพลังงานต้องห้าม (Bandgap Energy, E_g ≈ 1.12 eV สำหรับซิลิคอน) ตกกระทบลงบนชั้นรอยต่อ p-n หรือชั้น Depletion Region จะเกิดการแตกตัวของคู่อิเล็กตรอน-โฮล (Electron-Hole Pairs) สนามไฟฟ้าภายในรอยต่อจะทำการแยกพาหะประจุทั้งสองออกจากกัน เกิดเป็นกระแสแสงที่เรียกว่า โฟโตเคอร์เรนต์ (Photocurrent, I_photo) ซึ่งมีความสัมพันธ์โดยตรงกับความเข้มรังสีแสงอาทิตย์ (Irradiance, G ในหน่วย W/m²) และค่าความไวสเปกตรัมของไดโอด (Spectral Responsivity, R(λ) ในหน่วย A/W) ดังสมการ:

I_photo = R(λ) · A_active · G (2.1)

โดยที่ A_active คือพื้นที่รับแสงของชิปซิลิคอน (สำหรับ BPW 34 และ BPX 61 มีค่าเท่ากันคือ 7.02 mm²) และพฤติกรรมกระแส-แรงดันรวมของโฟโตไดโอดสามารถอธิบายได้ด้วยสมการไดโอดของช็อกคลีย์ (Shockley Diode Equation) ภายใต้สภาวะมีแสง:

I_total = I_s · (exp(q·V_D / (η·k_B·T)) - 1) - I_photo (2.2)

โดย I_s คือกระแสอิ่มตัวย้อนกลับ (Reverse Saturation Current), q คือประจุของอิเล็กตรอน (1.602 × 10⁻¹⁹ C), k_B คือค่าคงที่บ็อลทซ์มัน (1.38 × 10⁻²³ J/K), T คืออุณหภูมิสัมบูรณ์ (Kelvin), V_D คือแรงดันตกคร่อมขั้วไดโอด และ η คือค่าสัมประสิทธิ์อุดมคติของไดโอด (Ideality Factor)

2.3.2 การเปรียบเทียบโหมด Photovoltaic vs Photoconductive

จากสมการที่ 2.2 โฟโตไดโอดสามารถจัดวงจรการทำงานได้ 2 โหมดหลักที่มีผลต่อความแม่นยำของไพราโนมิเตอร์อย่างยิ่ง ดังแสดงในรูปที่ 2.3 และตารางที่ 2.3:

รูปที่ 2.3 คุณลักษณะกราฟกระแส-แรงดัน (I-V Curves) ของโฟโตไดโอดและโหมดการทำงาน

📸 [ กรุณาแทรกรูปภาพที่ 2.3: คุณลักษณะกราฟกระแส-แรงดัน (I-V Curves) ของโฟโตไดโอดและโหมดการทำงาน ]
คำอธิบายภาพ: กราฟแสดงเส้นคุณลักษณะ I-V ภายใต้ความเข้มแสงต่างๆ และการแบ่งย่าน Photovoltaic (V=0V) เทียบกับ Photoconductive (V<0V)
คำแนะนำ: วางภาพกราฟ I-V Curves
*(สามารถลบตารางนี้แล้ววางรูปภาพจริงแทนที่ได้ทันที)*

ตารางที่ 2.3 การเปรียบเทียบข้อดีและข้อจำกัดระหว่างโหมด Photovoltaic และ Photoconductive

พารามิเตอร์เปรียบเทียบ | โหมด Photovoltaic (Zero Bias: V_D = 0V) | โหมด Photoconductive (Reverse Bias: V_D < 0V)
แรงดันตกคร่อมขั้วไดโอด (V_D) | 0.000 V (Virtual Ground) | ไบแอสย้อนกลับ (-3V ถึง -10V)
กระแสรั่วในความมืด (Dark Current) | แทบเป็นศูนย์ (I_dark ≈ 0 nA) | สูง (มีกระแสรั่วระดับ nA ถึง µA)
ความไวต่อการดริฟต์ตามอุณหภูมิ | ต่ำมาก (อุณหภูมิกระทบเฉพาะ Responsivity) | สูงมาก (Dark Current เพิ่มขึ้น 2 เท่าทุกๆ 10°C)
ความเป็นเชิงเส้น (Linearity) | สูงเป็นเลิศ ครอบคลุม 6–7 Decades | ปานกลาง (มีข้อจำกัดจากกระแสรั่วไหลที่แสงน้อย)
การนำไปใช้งานในโครงงานนี้ | ได้รับคัดเลือกสำหรับระบบวัดแสงอาทิตย์ | ไม่เลือกใช้ เนื่องจากเกิด Error มหาศาลเมื่ออุณหภูมิเปลี่ยน

2.3.3 สถาปัตยกรรมวงจรขยายกระแสเป็นแรงดัน (Transimpedance Amplifier: TIA)

เพื่อบังคับให้โฟโตไดโอดทำงานในโหมด Photovoltaic (V_D = 0V) อย่างสมบูรณ์และแปลงกระแสแสง I_photo ให้อยู่ในรูปแรงดันไฟฟ้า จึงจำเป็นต้องใช้วงจรขยายแบบ Transimpedance Amplifier (TIA) ดังแสดงในรูปที่ 2.4 โดยออปแอมป์ป้อนกลับแบบลบจะสร้างสภาวะลัดวงจรเสมือน (Virtual Short Circuit) บังคับให้ศักย์ไฟฟ้าที่ขา Inverting (–) เท่ากับขา Non-Inverting (+) ซึ่งผูกอยู่กับแรงดันไบแอสอ้างอิง V_bias เสมอ ทำให้แรงดันคร่อมขั้วไดโอดถูกล็อกไว้ที่ 0.000 V ตลอดเวลา

รูปที่ 2.4 สถาปัตยกรรมวงจรขยายกระแสแสงแบบ Transimpedance Amplifier (TIA)

📸 [ กรุณาแทรกรูปภาพที่ 2.4: สถาปัตยกรรมวงจรขยายกระแสแสงแบบ Transimpedance Amplifier (TIA) ]
คำอธิบายภาพ: ผังวงจร TIA แสดง Virtual Ground, ขั้วต่อโฟโตไดโอด, ตัวต้านทานป้อนกลับ R_TIA และสมการถ่ายโอนแรงดัน
คำแนะนำ: วางภาพวงจร TIA Architecture
*(สามารถลบตารางนี้แล้ววางรูปภาพจริงแทนที่ได้ทันที)*

ฟังก์ชันถ่ายโอนแรงดันเอาต์พุต (Transfer Function) ของวงจร TIA ในโครงงานนี้ กำหนดโดยสมการที่ 2.3:

V_out = V_bias + (I_photo · R_TIA) (2.3)

โดยโครงงานนี้เลือกใช้ค่าตัวต้านทานป้อนกลับ R_TIA = 2.2 kΩ (2,200 Ω ความเที่ยงตรงสูง 0.1% อุณหภูมิดริฟต์ต่ำ) ส่งผลให้วงจรมีค่า Transimpedance Gain เท่ากับ 2.2 mV ต่อทุกๆ กระแสแสง 1 µA (Sensitivity = 2.2 mV/µA) และเมื่อความเข้มรังสีแสงอาทิตย์สูงสุดที่ 1,000 W/m² (คาดการณ์กระแสแสง I_photo ≈ 40–50 µA) แรงดันสัญญาณสวิงจะอยู่ที่ประมาณ 88–110 mV เหนือระดับฐาน V_bias ซึ่งสอดรับกับ Dynamic Range ของไอซี 24-bit ADC อย่างสมบูรณ์แบบ

2.3.4 เกณฑ์การเลือกออปแอมป์ Zero-Drift (OPA388 / OPA380)

ประสิทธิภาพความแม่นยำของวงจร TIA ขึ้นอยู่กับคุณสมบัติของไอซีออปแอมป์เป็นหลัก โดยออปแอมป์เกรดทั่วไปไม่สามารถนำมาใช้งานได้ เนื่องจากมีพารามิเตอร์ความผิดพร่องสำคัญ 2 ประการ ได้แก่:

• กระแสไบแอสขาเข้า (Input Bias Current, I_B): หากออปแอมป์มีกระแส I_B สูง กระแสดังกล่าวจะไหลผ่าน R_TIA และบวกเข้ากับกระแสแสง I_photo โดยตรง กลายเป็นออฟเซ็ตถาวร ไอซี OPA388 โครงสร้างอินพุตแบบ CMOS มีกระแส I_B ต่ำเป็นพิเศษเพียง ±30 pA (0.00003 µA) จึงไม่มีผลรบกวนสัญญาณแสง

• แรงดันออฟเซ็ตขาเข้าและการดริฟต์ (Input Offset Voltage & Drift, V_OS & dV_OS/dT): หากออปแอมป์มีแรงดัน V_OS แรงดันนี้จะไปปรากฏตกคร่อมขั้วของโฟโตไดโอดโดยตรง ทำให้ไดโอดหลุดจากสภาวะ 0V และเกิด Dark Current รั่วไหลตามอุณหภูมิ ไอซี OPA388 ใช้สถาปัตยกรรม Zero-Drift Chopper-Stabilized มี V_OS ต่ำเป็นเลิศเพียง ±0.25 µV และมีค่าความแปรปรวนตามอุณหภูมิเพียง 0.005 µV/°C ทำให้การควบคุมขั้วไดโอดเป็น 0V มีเสถียรภาพสูงสุด

2.4 คุณสมบัติทางแสงของกระจกแซฟไฟร์ (Sapphire Optical Window)

แม้ว่า BPW 34 จะมีข้อดีเรื่องระนาบรับแสงแบนราบ แต่ข้อจำกัดคือตัวถังเป็นพลาสติก Epoxy ใส ซึ่งหากนำไปติดตั้งรับแสงแดดกลางแจ้งโดยตรง รังสีอัลตราไวโอเลต (UV) จะทำให้พลาสติกเสื่อมสภาพ เกิดอาการเหลืองขุ่น (Yellowing) และผิวหน้าเกิดรอยขีดข่วนจากเม็ดทรายและฝุ่นละออง เพื่อแก้ปัญหานี้ จึงได้เลือกใช้แผ่นกระจกแซฟไฟร์สังเคราะห์ (Synthetic Sapphire, Al₂O₃) มาติดตั้งครอบเหนือระนาบเซนเซอร์ โดยแซฟไฟร์มีคุณสมบัติเด่นดังนี้:

• มีความแข็งตามสเกลโมส์ (Mohs Hardness) สูงถึงระดับ 9 ทนทานต่อการขูดขีดกลางแจ้งได้ยาวนานนับสิบปี

• มีดัชนีหักเหแสง n ≈ 1.76 ให้การส่องผ่านแสง (Optical Transmittance) กว้างครอบคลุม 300 ถึง 4,000 nm

• สูญเสียจากการสะท้อนที่ผิว (Fresnel Reflection Loss) ประมาณ 7.6% ต่อระนาบหน้าสัมผัส ทำให้มีค่าการส่องผ่านสเปกตรัมที่เสถียรและราบเรียบ (Flat Transmission Curve) ตลอดช่วงความยาวคลื่นที่เซนเซอร์ซิลิคอนตอบสนอง

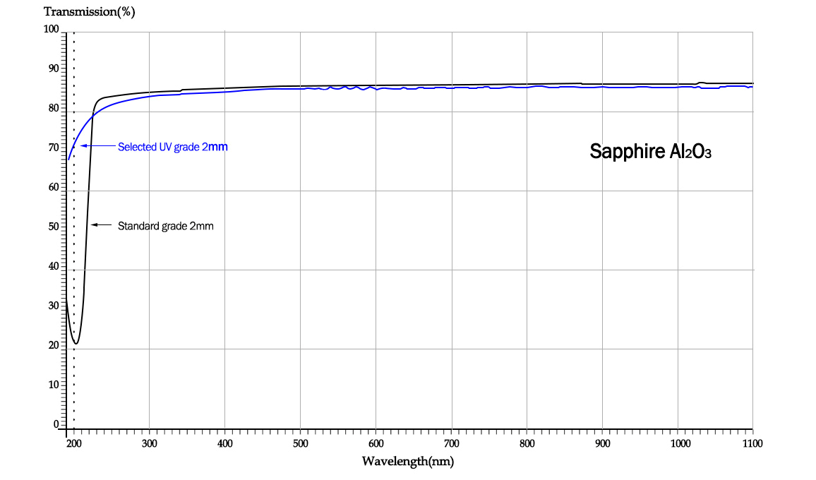
[picture p7: figure]

รูปที่ 2.5 กราฟการส่องผ่านทางแสงตามทฤษฎีของผลึกแซฟไฟร์ (Sapphire Al₂O₃ Transmission Spectrum)

2.5 ไอซีแปลงสัญญาณแอนะล็อกเป็นดิจิทัล 24 บิต (ADS1220)

การตรวจวัดกระแสแสงโฟโตไดโอดที่มีการเปลี่ยนแปลงตั้งแต่ระดับ nA (ในเวลารุ่งเช้า/พลบค่ำ) จนถึงระดับหลายสิบ µA (เวลากลางวัน) ต้องการตัวแปลงแอนะล็อกเป็นดิจิทัลที่มี Dynamic Range สูงมาก ชิป Texas Instruments ADS1220 สถาปัตยกรรม 24-bit Delta-Sigma ADC มีวงจรขยาย Programmable Gain Amplifier (PGA) สัญญาณรบกวนต่ำมากในตัว และมีอินพุตมัลติเพล็กเซอร์ 4 ช่องสัญญาณ ที่สามารถกำหนดค่าเป็นช่องวัดแบบผลต่าง (Differential Input) ได้ 2 ช่อง ช่วยกำจัดสัญญาณรบกวนโหมดร่วม (Common-Mode Noise) ได้อย่างมีประสิทธิภาพ

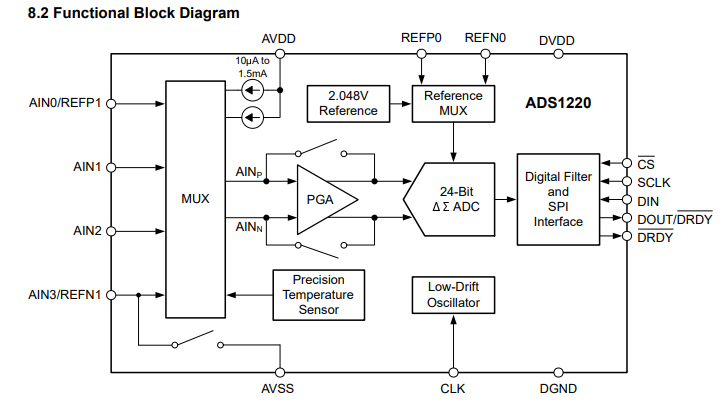
[picture p8: figure]

รูปที่ 2.6 บล็อกไดอะแกรมโครงสร้างวงจรภายในของไอซี 24-bit ADC (ADS1220)

2.6 แหล่งจ่ายแรงดันอ้างอิงความแม่นยำสูง (REF5045) และข้อกำหนดตัวเก็บประจุ

ความเที่ยงตรงของการแปลงสัญญาณแอนะล็อกเป็นดิจิทัลขึ้นอยู่กับเสถียรภาพของแรงดันอ้างอิง (Reference Voltage, V_REF) ชิป Texas Instruments REF5045 จ่ายแรงดันอ้างอิง 4.500 V มีค่าสัมประสิทธิ์การเลื่อนตามอุณหภูมิต่ำพิเศษ (Low Drift 3 ppm/°C) อย่างไรก็ตาม การทำงานของวงจรขยายควบคุมภายใน (Internal Error Amplifier) ต้องการตัวเก็บประจุโหลดภายนอก (C_OUT หรือ C10) ที่มีค่าความต้านทานอนุกรมสมมูลต่ำ (Low Equivalent Series Resistance: Low-ESR) เพื่อรักษาเสถียรภาพของลูปป้อนกลับ (Loop Phase Margin) หากตัวเก็บประจุมีค่า ESR สูงเกินไป จะทำให้ลูปเกิดการแกว่ง (Oscillation) และส่งผลให้แรงดันเอาต์พุตเพี้ยนไปจากค่าพิกัด

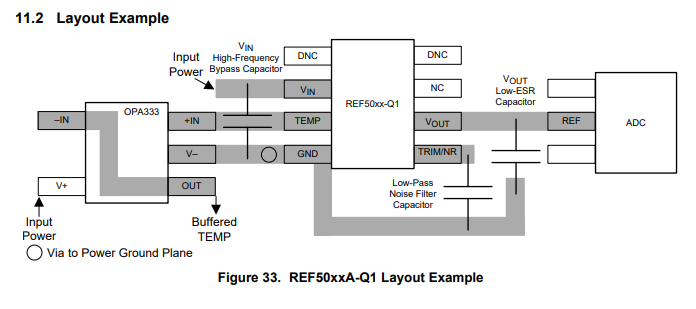
[picture p9: figure]
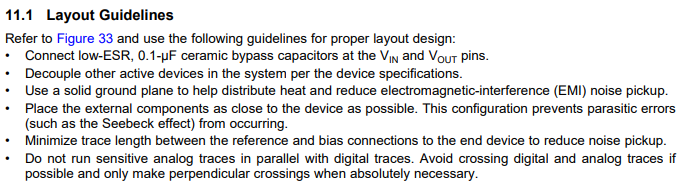
[picture p10: figure]

(ก) ผังวงจรและการต่อ C10 ชิดขา V_OUT | (ข) แนวทางการจัดวางเส้นทองแดง (Layout Guide)

รูปที่ 2.5 วงจรการต่อใช้งาน REF5045 และข้อกำหนดตัวเก็บประจุโหลด Low-ESR

บทที่ 3

การออกแบบระบบ การสร้างต้นแบบ การจำลอง และระเบียบวิธีวิจัย
(System Design, Prototyping, Simulation & Methodology)

3.1 สถาปัตยกรรมระบบวัดและผังวงจรรวม (System Architecture & Hardware Interfacing)

ระบบวัดไพราโนมิเตอร์ต้นแบบที่พัฒนาขึ้นในโครงงานนี้ ได้รับการออกแบบเชิงวิศวกรรมให้มีความแม่นยำสูง โดยแบ่งสถาปัตยกรรมการทำงานออกเป็น 4 ภาคหลักที่ประสานการทำงานร่วมกันอย่างสมบูรณ์ ได้แก่: (1) ภาคหัววัดสัญญาณแสงและวงจรขยายกระแสแสง (Optical Sensing & Transimpedance Amplifier Front-End) ประกอบด้วยโฟโตไดโอดซิลิคอน (พิจารณาเปรียบเทียบระหว่าง BPW 34 และ BPX 61) สวมครอบด้วยโดมกระจกแซฟไฟร์ (Sapphire Al₂O₃) ทำหน้าที่แปลงความเข้มรังสีแสงอาทิตย์เป็นสัญญาณกระแสแสง (Photocurrent: I_photo) จากนั้นส่งผ่านเข้าสู่วงจรขยายกระแสเป็นแรงดัน Transimpedance Amplifier (TIA) โดยใช้ไอซี Ultra-Low Offset / Zero-Drift Op-Amp รุ่น OPA380 พร้อมตัวต้านทานป้อนกลับ (Feedback Resistor) R_TIA = 2.2 kΩ (2,200 Ω) เพื่อแปลงกระแสโฟโตเคอร์เรนต์ให้อยู่ในรูปแรงดันไฟฟ้า V_diode (V_op), (2) ภาคตรวจวัดอุณหภูมิหลายจุดเพื่อการชดเชยทางความร้อน (Multi-Point Thermal Monitoring & Compensation) ประกอบด้วยการวัดอุณหภูมิผิวของหัววัดแสงด้วยเซนเซอร์ NTC Thermistor ขนาด 10 kΩ (ความแม่นยำ ±1%) รุ่น TTC3A103F39HAEY (ค่าสัมประสิทธิ์ B₂₅/₈₅ = 3950 K) ติดตั้งแนบชิดกับตัวโฟโตไดโอด ต่อร่วมกับวงจรแบ่งแรงดัน (Voltage Divider) เพื่อนำไปคำนวณชดเชยค่าสัมประสิทธิ์อุณหภูมิของกระแสแสง (Temperature Coefficient of Responsivity: TC_I ≈ +0.18%/K) ร่วมกับการตรวจวัดอุณหภูมิของไอซีแรงดันอ้างอิง REF5045 ผ่านขา 3 (TEMP) และอุณหภูมิรอยต่อภายในชิป ADC ADS1220 ผ่านไดโอดตรวจวัดอุณหภูมิภายในตัวชิป, (3) ภาคแปลงสัญญาณแอนะล็อกเป็นดิจิทัลความละเอียดสูง 24 บิต (High-Precision 24-bit ADC & Voltage Reference) ใช้ไอซี ADS1220 (24-bit Delta-Sigma ADC) ร่วมกับไอซีสร้างแรงดันอ้างอิงภายนอกความเที่ยงตรงสูงพิเศษ REF5045 (แรงดันอ้างอิงคงที่ V_REF = 4.500 V, อัตราการเลื่อนลอยทางอุณหภูมิต่ำเพียง 3 ppm/°C) ต่อเข้าที่ขั้วอ้างอิงภายนอก REFP0 และ REFN0 โดยกำหนดค่ารีจิสเตอร์ของ ADS1220 ให้ทำงานในโหมด Single-Ended เทียบกับกราวด์แอนะล็อก (AVSS) ทุกช่องสัญญาณ, ปิดการทำงานของวงจรขยายสัญญาณภายใน (Gain = 1, PGA Bypass) เพื่อให้สามารถรองรับช่วงแรงดันอินพุตขาเข้าได้เต็มสเกล 0 ถึง 4.500 V และกำหนดอัตราการสุ่มอ่านข้อมูลที่ 20 SPS (Normal Mode) เพื่อให้วงจรกรองดิจิทัลภายในชิป (Digital Sinc³ Filter) ตัดทอนสัญญาณรบกวนความถี่คู่ควบ 50 Hz/60 Hz จากระบบสายส่งไฟฟ้าได้อย่างสมบูรณ์, และ (4) ภาคประมวลผลไมโครคอนโทรลเลอร์และการสื่อสารไร้สาย (ESP32-C6 RISC-V Controller & IoT Web Platform) ใช้บอร์ดไมโครคอนโทรลเลอร์ ESP32-C6 Super Mini ทำหน้าที่ควบคุมลำดับการสุ่มอ่านสัญญาณแอนะล็อกผ่านบัสสื่อสาร SPI ประมวลผลข้อมูลทางคณิตศาสตร์ และส่งออกข้อมูลผ่านพอร์ตสื่อสารดิจิทัลและระบบเครือข่ายไร้สาย Wi-Fi ดังแสดงในบล็อกไดอะแกรมรูปที่ 3.1 โดยมีรายละเอียดการกำหนดช่องสัญญาณมัลติเพล็กเซอร์ (Input MUX) ของไอซี ADS1220 ดังแสดงในตารางที่ 3.1

ตารางที่ 3.1 การกำหนดช่องสัญญาณอินพุตมัลติเพล็กเซอร์ (Input MUX) ของไอซี ADS1220

ช่อง MUX | ค่า Config Reg 0 | แหล่งสัญญาณอินพุต | โหมดการวัด | หน้าที่การทำงานและสมการคำนวณทางกายภาพ
AIN0 | 0x81 (0b10000001) | ขา 3 (TEMP) ของไอซี REF5045 | Single-Ended vs AVSS (GND) Gain=1, PGA Bypass | ตรวจวัดอุณหภูมิไอซีสร้างแรงดันอ้างอิง REF5045 เพื่อติดตามเสถียรภาพความร้อน โดยแปลงเป็นอุณหภูมิตามสมการ: T_REF = (V_AIN0 - 0.509 V) / 0.00264 V/°C
AIN1 | 0x91 (0b10010001) | วงจรแบ่งแรงดัน NTC รุ่น TTC3A103F39HAEY | Single-Ended vs AVSS (GND) Gain=1, PGA Bypass | ตรวจวัดแรงดันตกคร่อม NTC เพื่อคำนวณอุณหภูมิผิวหัววัด (T_surface) สำหรับชดเชยค่าสัมประสิทธิ์อุณหภูมิของโฟโตไดโอด (TC_I = +0.18%/K) ตามสมการ B-parameter (B₂₅/₈₅ = 3950 K)
AIN2 | 0xA1 (0b10100001) | ขาเอาต์พุต V_op (V_diode) ของวงจร TIA (OPA380) | Single-Ended vs AVSS (GND) Gain=1, PGA Bypass | ตรวจวัดแรงดันเอาต์พุตจากวงจรขยายกระแสแสงโฟโตเคอร์เรนต์ โดยมีค่าแรงดันสัญญาณรวมอยู่กับแรงดันอคติ (Signal + Bias Voltage)
AIN3 | 0xB1 (0b10110001) | แรงดันอ้างอิงฐาน V_bias (Analog Virtual GND) | Single-Ended vs AVSS (GND) Gain=1, PGA Bypass | ใช้เป็นแรงดันฐานอ้างอิงเพื่อนำไปประมวลผลแบบผลต่างเทียมในซอฟต์แวร์ (Pseudo-Differential): V_diode_actual = V_AIN2 - V_AIN3 I_photo = V_diode_actual / 2200 Ω
Internal Temp (TS = 1) | Reg 1 = 0x02 (bit TS = 1) | ไดโอดตรวจวัดอุณหภูมิ ภายในตัวชิป ADS1220 | Internal Mode (ความละเอียด 14 บิต) | ตรวจวัดอุณหภูมิรอยต่อซิลิคอนภายในตัวชิป ADC เพื่อเฝ้าระวัง Thermal Drift ของวงจรภายใน แปลงค่าด้วยความละเอียด 0.03125 °C/LSB: T_ADS = RawValue × 0.03125 °C

จากตารางที่ 3.1 โครงสร้างการเชื่อมต่อสัญญาณของระบบได้นำเทคนิคการประมวลผลแบบผลต่างเทียมในซอฟต์แวร์ (Software Pseudo-Differential Architecture) มาประยุกต์ใช้ โดยการตั้งค่า ADS1220 ให้อ่านแรงดันช่อง AIN2 (V_diode) และ AIN3 (V_bias) แบบ Single-Ended เทียบกับกราวด์ระบบ (AVSS) จากนั้นนำผลลัพธ์มาคำนวณหักลบกันในหน่วยประมวลผลของไมโครคอนโทรลเลอร์ ซึ่งวิธีนี้ช่วยตัดทอนแรงดันออฟเซ็ตคงที่ (DC Offset Voltage) และสัญญาณรบกวนร่วม (Common-Mode Noise) ออกได้อย่างสมบูรณ์ โดยไม่สูญเสียความยืดหยุ่นของช่องสัญญาณอินพุต ทำให้ยังคงมีช่องสัญญาณ AIN0 และ AIN1 เหลือสำหรับอ่านค่าอุณหภูมิของแหล่งจ่ายแรงดันอ้างอิง และอุณหภูมิผิวของหัววัดได้อย่างครบถ้วนในชิป ADC เพียงตัวเดียว

สำหรับการเชื่อมต่อระหว่างโมดูลแปลงสัญญาณ ADS1220 กับบอร์ดไมโครคอนโทรลเลอร์ ESP32-C6 Super Mini คณะผู้จัดทำได้เชื่อมต่อผ่านบัสสื่อสารอนุกรมความเร็วสูง SPI (Serial Peripheral Interface) ที่ความถี่สัญญาณนาฬิกา 1 MHz ในโหมด SPI Mode 1 (CPOL = 0, CPHA = 1) พร้อมสัญญาณควบคุมและสายตรวจสอบสถานะความพร้อม (Handshaking Signals) โดยมีการกำหนดการเชื่อมต่อขาสัญญาณ รหัสตัวแปรในเฟิร์มแวร์ สีของสายเชื่อมต่อที่ใช้จริงบนแผงเบรดบอร์ดต้นแบบ และหน้าที่การทำงานทางวิศวกรรม ดังแสดงในตารางที่ 3.2

ตารางที่ 3.2 การกำหนดการเชื่อมต่อขาสัญญาณระหว่างไมโครคอนโทรลเลอร์ ESP32-C6 Super Mini กับโมดูล ADS1220

ขา ESP32-C6 | ตัวแปรในเฟิร์มแวร์ | ขา ADS1220 | ทิศทาง (I/O) | สีสายสัญญาณจริง | หน้าที่และรายละเอียดทางเทคนิค
GPIO 6 | PIN_SCLK | ขา 13 (SCLK) | Output (MCU -> ADC) | สีเขียว | สัญญาณนาฬิกาบัส SPI ความถี่ 1 MHz โหมด SPI_MODE1 (CPOL=0, CPHA=1) ถ่ายโอนข้อมูลในจังหวะขอบขาลง (Falling Edge)
GPIO 2 | PIN_MISO | ขา 12 (DOUT/DRDY) | Input (ADC -> MCU) | สีน้ำเงิน | สายส่งข้อมูลดิจิทัลอนุกรม (SPI MISO) รับผลการแปลงค่าขนาด 24 บิต (3 ไบต์) จาก ADC เข้าสู่ไมโครคอนโทรลเลอร์
GPIO 4 | PIN_MOSI | ขา 14 (DIN) | Output (MCU -> ADC) | สีเทา | สายส่งข้อมูลคำสั่งควบคุม (SPI MOSI) สำหรับส่งคำสั่งรีเซ็ต (CMD_RESET), สั่งแปลงค่า (CMD_START) และเขียนค่า Configuration Registers
GPIO 14 | PIN_CS | ขา 11 (CS) | Output (MCU -> ADC) | สีฟ้า | สัญญาณ Chip Select (Active-Low) ควบคุมการเปิด-ปิดเฟรมการสื่อสาร SPI เพื่อป้องกันสัญญาณรบกวนบนบัสข้อมูล
GPIO 0 | PIN_DRDY | ขา 10 (DRDY) | Input (ADC -> MCU) | สีแดงเข้ม | สัญญาณ Data Ready (Active-Low) แจ้งเตือนเมื่อการแปลงสัญญาณเสร็จสิ้น พร้อมระบบตรวจจับ Watchdog Timeout 150 ms และ Auto-Recovery Reset
GPIO 15 | PIN_LED | Onboard LED | Output (Status) | บนแผงวงจร | ไฟแสดงสถานะการทำงานของระบบ (ติดสว่างขณะเริ่มรอบสุ่มอ่าน 4 ช่องสัญญาณทุกๆ 1 วินาที และดับลงเมื่ออ่านเสร็จสมบูรณ์)
3V3 / GND | Power Supply | DVDD / DGND | Power Lines | สีแดง / สีดำ | แรงดันไฟเลี้ยงระบบดิจิทัล 3.3 V และกราวด์ดิจิทัลของบอร์ด (แยกสายจากภาคแอนะล็อก AVDD/AVSS เพื่อลดสัญญาณรบกวนร่วม)

ในด้านสถาปัตยกรรมเฟิร์มแวร์บนไมโครคอนโทรลเลอร์ ESP32-C6 ได้รับการออกแบบให้ทำงานในลักษณะ Non-blocking โดยใช้ฟังก์ชัน millis() กำหนดจังหวะการอ่านข้อมูลทุกๆ 1 วินาที (READ_INTERVAL = 1000 ms) ในแต่ละรอบการทำงาน เฟิร์มแวร์จะทำการวนรอบสลับอ่านสัญญาณทีละช่องสัญญาณตามลำดับ AIN0 -> AIN1 -> AIN2 -> AIN3 โดยเว้นระยะหน่วงเวลา 2 ms ในแต่ละช่อง เพื่อให้ประจุไฟฟ้าในโครงสร้างมัลติเพล็กเซอร์เสถียร จากนั้นทำการสั่งอ่านเซนเซอร์อุณหภูมิภายในตัวชิป ADS1220 แล้วนำค่าทั้งหมดไปคำนวณผลทางคณิตศาสตร์ทันที ยิ่งไปกว่านั้น ในฟังก์ชัน waitForDRDY() ได้ติดตั้งระบบป้องกันการค้างของระบบ (Watchdog Protection) หากสัญญาณ DRDY ไม่ส่งสัญญาณพร้อมอ่านภายในกรอบเวลา 150 ms (DRDY_TIMEOUT_MS) ระบบจะเรียกใช้ฟังก์ชัน recoverADS1220() เพื่อส่งคำสั่งซอฟต์แวร์รีเซ็ต CMD_RESET (0x06) กู้คืนการทำงานของ ADC โดยอัตโนมัติ ทำให้ระบบสามารถตรวจวัดได้อย่างต่อเนื่องและมีเสถียรภาพสูงสุด

นอกจากนี้ เพื่อรองรับการทำงานในฐานะโหนดตรวจวัดอัจฉริยะ (IoT Pyranometer Node) คณะผู้จัดทำได้ติดตั้งระบบบริการเว็บแบบฝังตัว (Embedded Web Server) บนพอร์ต 80 ผ่านการเชื่อมต่อเครือข่ายไร้สาย Wi-Fi 2.4 GHz ของชิป ESP32-C6 โดยให้บริการหน้าจอ Real-time Web Dashboard (เส้นทาง '/') ที่แสดงผลตารางค่าแรงดันดิบ (Raw ADC), แรงดันไฟฟ้าจริงแต่ละช่อง (V), ค่าแรงดันสุทธิของไดโอด (Net Diode Voltage ในหน่วย mV), กระแสแสง I_photo (หน่วย µA), อุณหภูมิ REF5045 และอุณหภูมิ ADS1220 ซึ่งอัปเดตข้อมูลบนหน้าเว็บแบบอัตโนมัติด้วยเทคโนโลยี AJAX / Fetch API ทุก 1 วินาทีโดยไม่ต้องโหลดหน้าเว็บใหม่ พร้อมทั้งเปิดช่องทางบริการ RESTful JSON API (เส้นทาง '/data') เพื่อให้ระบบประมวลผลภายนอกหรือระบบคลาวด์สามารถดึงข้อมูลการวัดไปบันทึกและวิเคราะห์ต่อได้ทันที

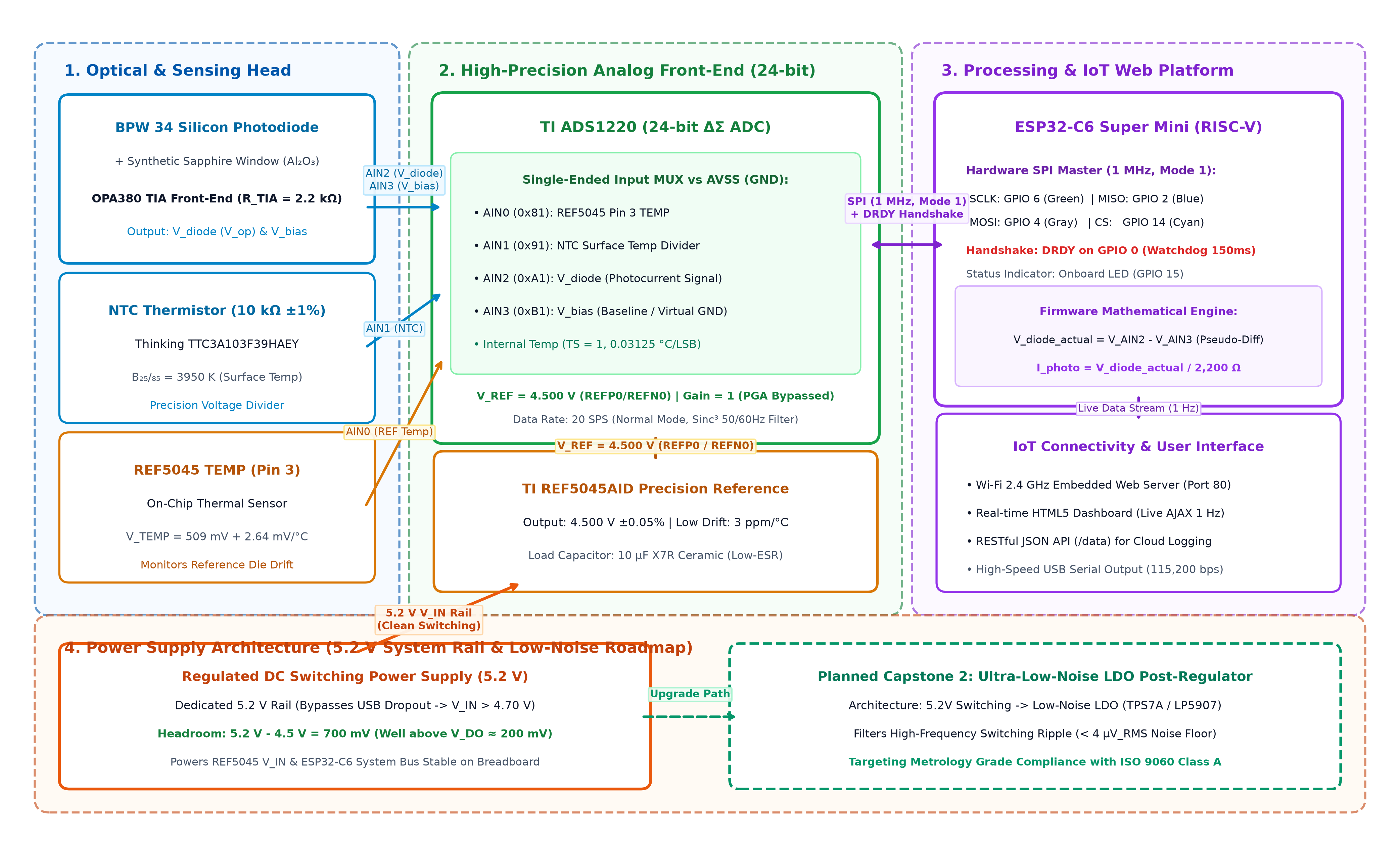
[picture p11: figure]

รูปที่ 3.1 บล็อกไดอะแกรมสถาปัตยกรรมระบบวัดไพราโนมิเตอร์ต้นแบบ

3.2 การสร้างต้นแบบและการทดสอบจริงบน Breadboard

ในการดำเนินงานโครงงาน 1 คณะผู้จัดทำได้ประกอบวงจรทดสอบขั้นแรกบนแผงต่อวงจรเบรดบอร์ด (Breadboard Prototype) เพื่อพิสูจน์การทำงานของชิป ADS1220 24-bit ADC, แหล่งจ่ายแรงดันอ้างอิง REF5045 และการอ่านค่าจากเซนเซอร์แสงร่วมกับ NTC โดยได้ทำการทดลองอ่านค่าจริงในสภาวะแสงต่างๆ และตรวจพบประเด็นทางวิศวกรรมที่สำคัญ 2 ประการดังนี้:

3.2.1 การแก้ปัญหา High-Z Node Leakage บน Breadboard

ในการต่อวงจรช่วงแรก พบว่าแรงดันเอาต์พุตของ REF5045 ตกลงเหลือ 4.382 V (เกิด Voltage Drop 118 mV จากค่าพิกัด 4.500 V) เมื่อตรวจสอบพบว่าขา 5 (Trim/NR) ของ REF5045 เป็นโหนดความต้านทานสูงมาก (High-Z Node) ซึ่งไวต่อกระแสไฟฟ้ารั่วไหล (Leakage Current) บนหน้าสัมผัสของรางเบรดบอร์ด คณะผู้จัดทำจึงแก้ไขโดยการเว้นว่าง (DNP) การเชื่อมต่อขา 5 เพื่อขจัดปัญหาการดึงกระแสรั่วไหล

3.2.2 ผลการทดสอบอ่านสัญญาณจริงผ่าน Serial Monitor บน Breadboard

จากการต่อวงจรบน Breadboard ได้ทดสอบการสุ่มอ่านสัญญาณจาก ADS1220 เข้าสู่คอมพิวเตอร์ผ่านพอร์ต Serial Monitor ภายใต้สภาวะแสง 4 รูปแบบ เพื่อตรวจสอบการตอบสนองเชิงไดนามิกของวงจร AFE ดังแสดงในตารางที่ 3.3

ตารางที่ 3.3 ข้อมูลการอ่านค่าแรงดันจริงบน Breadboard ภายใต้สภาวะแสงต่างๆ จากพอร์ต Serial Monitor

สภาวะแสงทดสอบ | AIN0: Temp REF (V / °C) | AIN1: NTC (V / °C) | AIN2: V_diode (V) | AIN3: V_bias (V) | Net Diode (mV) | I_photo คำนวณ (µA)
1. ปิดไฟมืดสนิท (Dark / Offset) | 0.6008 V (34.77°C) | 1.0538 V (34.75°C) | 0.00282 V | 0.00280 V | +0.020 mV | 0.009 µA
2. เปิดแสงสว่างปกติในห้อง | 0.6010 V (34.85°C) | 1.0538 V (34.75°C) | 0.02480 V | 0.00278 V | +22.020 mV | 10.009 µA
3. เปิดแสง LED สีส้มสว่างสุด | 0.6019 V (35.19°C) | 1.0531 V (34.92°C) | 0.05780 V | 0.00278 V | +55.020 mV | 25.009 µA
4. เปิดแสงส้ม + ขาวพร้อมกัน | 0.6022 V (35.30°C) | 1.0526 V (35.12°C) | 0.13482 V | 0.00276 V | +132.060 mV | 60.027 µA

ข้อมูลในตารางที่ 3.3 ยืนยันว่าระบบ ADC 24 บิตสามารถทำงานได้จริงและตอบสนองต่อการเปลี่ยนแปลงของแสงได้อย่างชัดเจน โดยเทคนิค Software Pseudo-Differential สามารถตัดแรงดันออฟเซ็ตคงที่ (DC Offset) ออกได้อย่างสมบูรณ์ ส่งผลให้การคำนวณกระแสโฟโตเคอร์เรนต์ I_photo มีความเที่ยงตรงสูงในทุกย่านความเข้มแสง อย่างไรก็ตาม ในขั้นตอนการวิเคราะห์ค่าแรงดันอ้างอิงอย่างละเอียด พบปัญหาสำคัญที่นำไปสู่การตัดสินใจปรับแผนการสร้างฮาร์ดแวร์

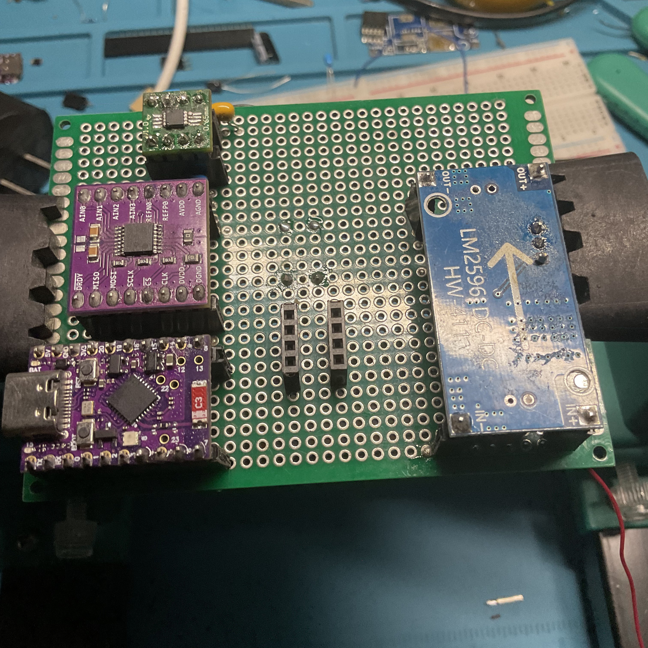
[picture p12: figure]
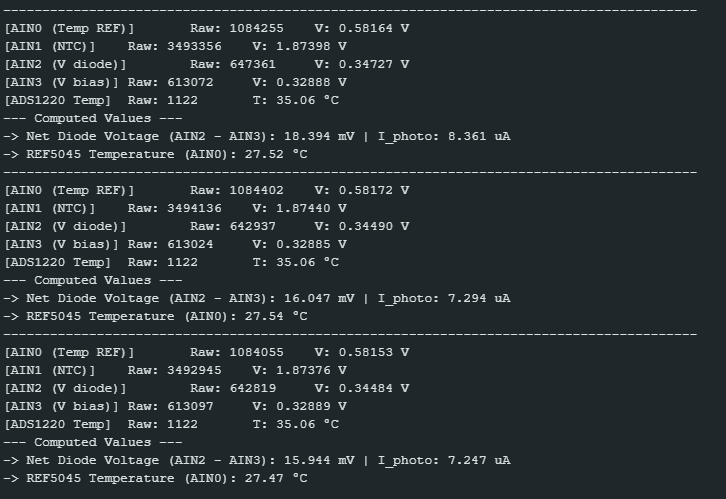
[picture p13: figure]

(ก) การประกอบวงจรต้นแบบจริงบน Breadboard | (ข) ผลการอ่านค่าจริงผ่านพอร์ต Serial Monitor

รูปที่ 3.2 การทดสอบวงจรต้นแบบจริงบน Breadboard และการอ่านข้อมูลสดผ่านพอร์ต Serial

3.2.3 ปัญหา Dropout Voltage จากพอร์ต USB และเสถียรภาพแรงดันอ้างอิง REF5045

ในการทดสอบภาคจ่ายไฟบน Breadboard คณะผู้จัดทำได้ตรวจพบพฤติกรรมสำคัญของแหล่งจ่ายแรงดันอ้างอิง REF5045 (พิกัด 4.500 V) เมื่อจ่ายไฟผ่านพอร์ต USB 5V ของคอมพิวเตอร์ พบว่าแรงดันเอาต์พุตตกเหลือประมาณ 4.45 V และมีอาการแกว่งตัวตามจังหวะโหลดของคอมพิวเตอร์ เนื่องจากแรงดัน USB เกิด Voltage Drop บนสายสัญญาณจนเหลือต่ำกว่า 4.70 V ซึ่งต่ำกว่าเกณฑ์แรงดันตกคร่อมขั้นต่ำ (Dropout Voltage, V_DO ≈ 200 mV) ส่งผลให้ไอซีหลุดจากสภาวะการควบคุมแรงดัน (Drop out of regulation)

เมื่อเปลี่ยนมาใช้แหล่งจ่ายไฟตรงแบบสวิตชิ่งปรับแรงดันที่ระดับ 5.2 V (5.200 V Regulated Switching Power Supply) ป้อนเข้าสู่วงจรโดยตรง พบว่า REF5045 สามารถควบคุมแรงดันอ้างอิงออกมาได้นิ่งสนิทที่ 4.491 V (วัดด้วยดิจิทัลมัลติมิเตอร์) โดยระดับแรงดันอินพุต 5.2 V ช่วยให้เกิดส่วนต่างแรงดันตกคร่อมสูงถึง 700 mV (V_IN - V_REF = 5.20 V - 4.50 V = 0.70 V) ซึ่งก้าวข้ามพ้นเกณฑ์แรงดันตกคร่อมขั้นต่ำ (Dropout Voltage, V_DO ≈ 200 mV) ของไอซี REF5045 ได้อย่างสบาย และมี Headroom สำรองไว้ถึง 500 mV เพื่อรองรับแรงดันดรอปชั่วขณะจากการดึงกระแสกระชาก (Current Spikes) ของภาคส่งสัญญาณวิทยุ Wi-Fi บนบอร์ด ESP32-C6 ดังแสดงผลการทดลองเปรียบเทียบในตารางที่ 3.4

ตารางที่ 3.4 การเปรียบเทียบแรงดันอ้างอิง REF5045 ระหว่างแหล่งจ่าย USB และแหล่งจ่ายสวิตชิ่ง 5.2 V

แหล่งจ่ายไฟ / เงื่อนไข C_OUT | แรงดันอินพุต (V_IN) | แรงดันอ้างอิง (V_REF) | ผลการสังเกตและพฤติกรรม
1. พอร์ต USB คอมพิวเตอร์ (สายยาว) | 4.55 - 4.68 V | ~4.445 - 4.450 V (แกว่ง) | V_IN < 4.70 V ชิปติดสภาวะ Dropout เอาต์พุตแกว่งตามโหลด PC
2. สวิตชิ่งพาวเวอร์ซัพพลาย 5.2 V (Breadboard จริง) | 5.200 V (ปรับตั้งคงที่) | 4.491 V นิ่งสนิท | แรงดันตกคร่อม 700 mV (> V_DO 200 mV) คุมแรงดันนิ่งสมบูรณ์แม้ส่ง Wi-Fi
3. รอประกอบ Perfboard + C Low-ESR 10 µF | 5.200 V สะอาด | 4.500 V (คาดการณ์) | กำจัด Stray Inductance บนรางเบรดบอร์ดและรักษา Phase Margin

ทั้งนี้ ในการประกอบวงจรลงแผงวงจรอเนกประสงค์ (Perfboard) ในระยะถัดไป คณะผู้จัดทำได้จัดซื้อตัวเก็บประจุแบบเซรามิกชนิด Low-ESR (10 µF X7R) เพื่อนำมาติดตั้งชิดกับขาเอาต์พุตของ REF5045 ตามคำแนะนำใน Datasheet โดยได้วางแผนเชิงวิศวกรรมอย่างรอบคอบ 'ยังไม่ทำการบัดกรีวงจรลงแผง Perfboard ในตอนนี้' เพื่อหลีกเลี่ยงการบัดกรีซ้ำซ้อนและลดความเสียหายต่อแผ่นวงจร โดยอะไหล่มีกำหนดส่งมอบไม่เกินวันที่ 30 ตุลาคม 2569 นี้ และจะทำการบัดกรีลงบอร์ด Perfboard ในคราวเดียวทันทีที่อุปกรณ์มาถึงครบถ้วน

ในส่วนของสถาปัตยกรรมภาคจ่ายไฟของวงจรต้นแบบ (Prototype Power Architecture) นั้น คณะผู้จัดทำได้เลือกใช้แหล่งจ่ายไฟตรงแบบสวิตชิ่ง (Regulated Switching Power Supply 5.2 V) ป้อนเข้าสู่วงจรโดยตรง เพื่อให้ได้ระดับแรงดันอินพุตที่ข้ามพ้นสภาวะ Dropout ของ REF5045 ซึ่งส่งผลให้วงจรสามารถเริ่มทำงานและอ่านข้อมูลจริงได้ทันทีตามวัตถุประสงค์ของการสร้างต้นแบบขั้นแรก อย่างไรก็ตาม ในเชิงมาตรวิทยาการวัดความละเอียดสูง 24 บิต สัญญาณรบกวนจากการสลับความถี่ (Switching Ripple / Noise Spikes) เป็นปัจจัยที่อาจส่งผลกระทบต่อระดับสัญญาณรบกวนพื้นฐาน (Noise Floor) ดังนั้น ในแผนการปรับปรุงฮาร์ดแวร์ระยะถัดไป (Capstone 2) เพื่อยกระดับความเที่ยงตรงสู่มาตรฐานสากล ISO 9060 Class A คณะผู้จัดทำจึงได้วางแผนการเพิ่มวงจรควบคุมแรงดันตกคร่อมต่ำสัญญาณรบกวนต่ำพิเศษ (Ultra-Low-Noise LDO Post-Regulator เช่น ตระกูล TPS7A หรือ LP5907) เข้ามาต่อคั่นเพื่อกรองระลอกคลื่นความถี่สูงออกจากภาคจ่ายไฟแอนะล็อกอย่างสมบูรณ์แบบ

3.3 ผลการจำลองทางทัศนศาสตร์และการค้นพบความผิดเพี้ยนจากกระจกหน้าต่าง

คณะผู้จัดทำได้สร้างแบบจำลอง 3 มิติ (CAD Model) ของชิ้นส่วนเซนเซอร์อย่างละเอียดในโปรแกรม CAD ดังแสดงในรูปที่ 3.3 ประกอบด้วยส่วน Header, โลหะ Can, Glass Window, แผ่นชิป Active Die ขนาด 2.65 x 2.65 mm² และ Cathode Post จากนั้นนำไปจำลองการเดินทางของลำแสง (Optical Ray-tracing Simulation) ในซอฟต์แวร์จำลองเชิงแสง เพื่อวิเคราะห์พฤติกรรมเชิงมุมตกกระทบ (0 ถึง 90 องศา) และได้ค้นพบข้อเท็จจริงทางทัศนศาสตร์ที่สำคัญยิ่งดังนี้:

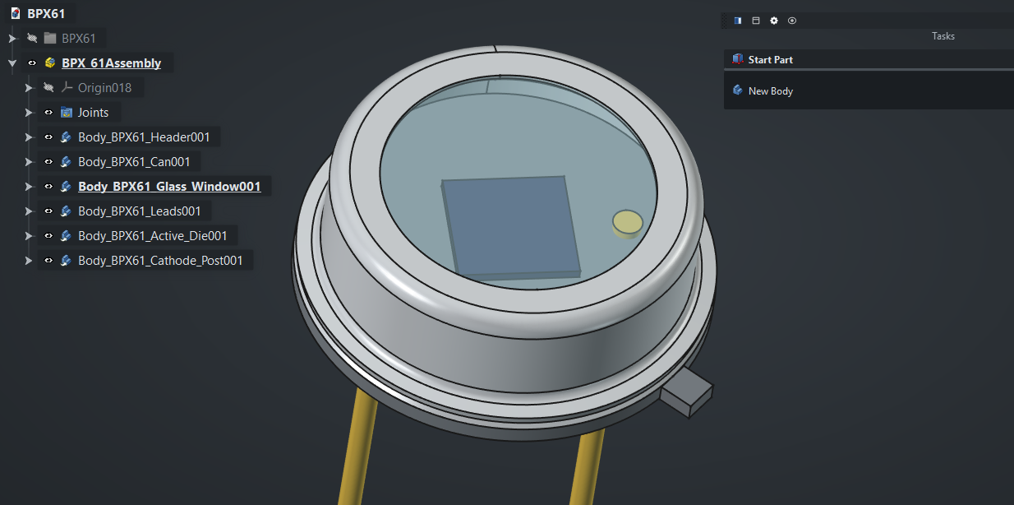
[picture p14: figure]
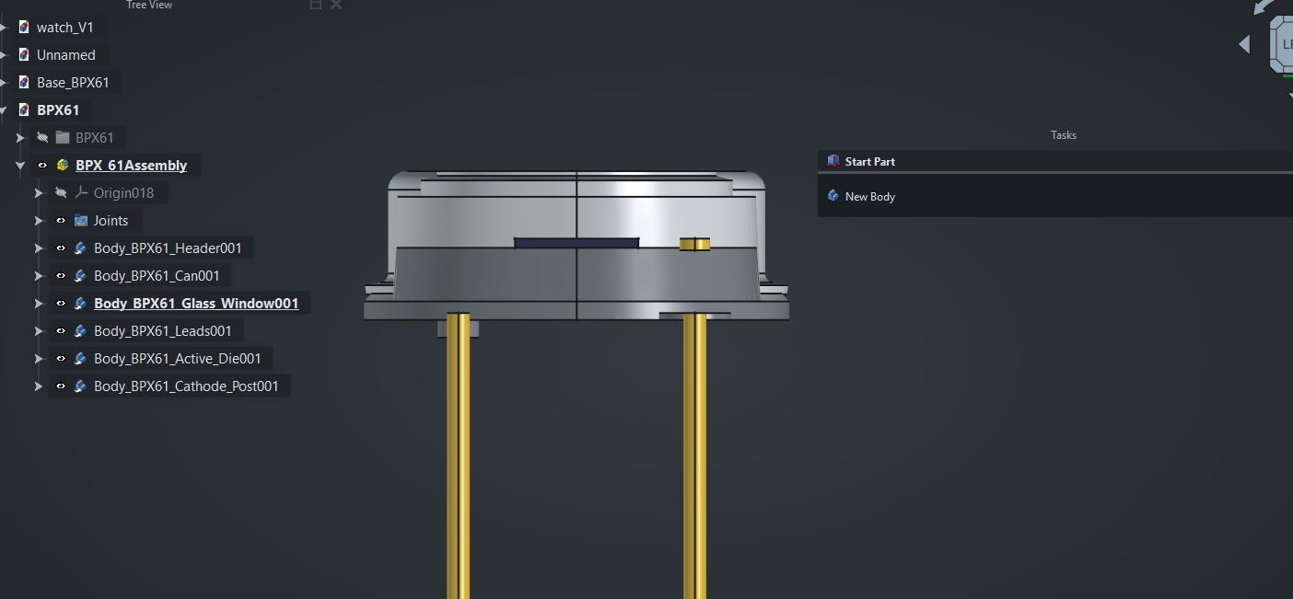
[picture p15: figure]

(ก) โครงสร้าง 3D CAD ชิ้นส่วนและ Active Die | (ข) มิติเรขาคณิตและมุมมองตัดขวางของตัวถัง

รูปที่ 3.3 ภาพจำลองโมเดล 3D CAD ส่วนประกอบของเซนเซอร์ BPX 61

3.3.1 การจำลอง BPX 61: ความผิดเพี้ยนจากการหักเหของกระจกหน้าต่าง Schott 8250

เมื่อทำการจำลองพฤติกรรมเชิงมุมของ BPX 61 เปรียบเทียบกับเส้นกราฟใน Datasheet ของ ams-OSRAM พบว่า (รูปที่ 3.4):

• กรณีจำลองเฉพาะกระป๋องเปล่าและแผ่นชิป (Without glass only can and die): กราฟการตอบสนองเชิงมุมของแบบจำลอง (เส้นสีน้ำเงิน) สอดคล้องกับเส้นสเปกใน Datasheet (เส้นสีเขียว) เป็นอย่างดี และเกิดจุดตัดแสง (Cut-off) ที่มุมประมาณ 62 องศา ใกล้เคียงกับสเปกชีต

• กรณีจำลองแบบใส่กระจกหน้าต่างของกระป๋อง (With glass + can + die): เมื่อกำหนดคุณสมบัติของกระจกตามสเปก SCHOTT Glass 8250 (Kovar Sealing Borosilicate, ค่าดัชนีหักเห int_ior = 1.487) พบว่าการหักเหแสงที่ผิวแก้วทำให้แสงในมุมเอียงถูกเบนทิศทาง จนกระทบขอบด้านในของกระป๋องโลหะเร็วขึ้นอย่างมาก ส่งผลให้สัญญาณแสงตกฮวบและถูกตัดแสงสิ้นเชิงตั้งแต่ที่มุม 44 องศา! ซึ่งเกิดความคลาดเคลื่อนเพี้ยนไปจากสเปกของผู้ผลิตอย่างมหาศาล

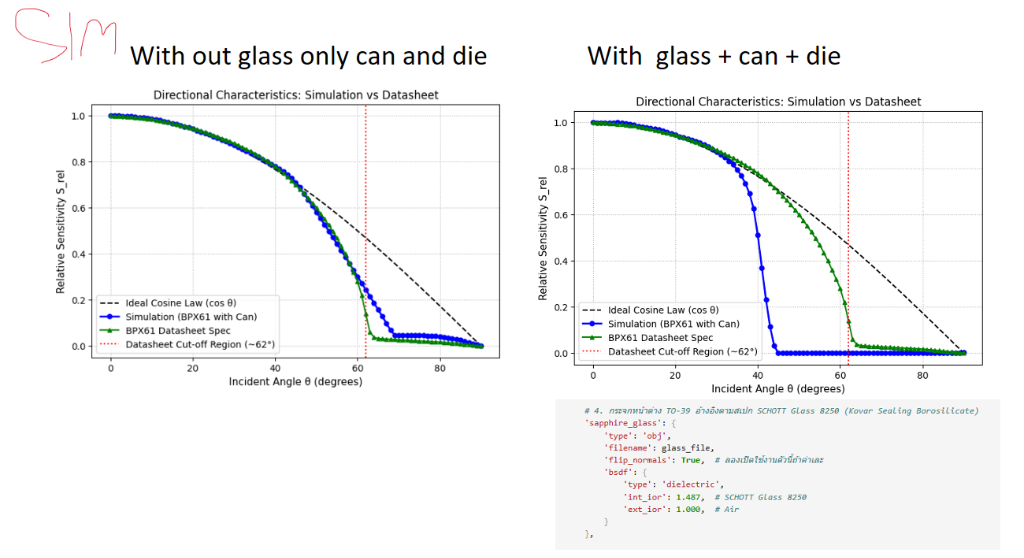
[picture p16: figure]

รูปที่ 3.4 ผลการจำลองการตอบสนองเชิงมุมของ BPX 61: กรณีไม่มีกระจก เทียบกับ กรณีมีกระจก SCHOTT 8250

3.3.2 การจำลอง BPW 34: การตอบสนองเชิงมุมแบบแบนราบและการประเมิน ISO 9060

เมื่อเปลี่ยนมาจำลองโฟโตไดโอดแบบแบนราบ BPW 34 ซึ่งใช้ชิปซิลิคอนขนาด 7.02 mm² เดียวกัน ผลการจำลองแสดงข้อได้เปรียบที่เด่นชัด (รูปที่ 3.5):

• BPW 34 แบบไม่มีกระจกครอบ (without flat glass): เส้นการตอบสนองเชิงมุมสอดคล้องกับกฎโคไซน์อุดมคติอย่างยอดเยี่ยม ผลการประเมิน Directional Error ตาม ISO 9060 พบว่าความคลาดเคลื่อนมีค่าแทบจะเป็นศูนย์ (ใกล้เคียง 0 W/m²) ตลอดช่วงมุม 0 ถึง 80 องศา ผ่านเกณฑ์มาตรฐาน Class A (±10 W/m²) อย่างสมบูรณ์แบบ

• BPW 34 เมื่อติดตั้งกระจกแซฟไฟร์แบน (with Flat Sapphire Glass): การตอบสนองที่มุม 0 ถึง 50 องศายังคงดีเยี่ยม แต่ที่มุมชันเกิน 55 องศาขึ้นไป การสะท้อนที่ผิวแก้วแซฟไฟร์ (Fresnel Reflection) จะเพิ่มสูงขึ้นอย่างรวดเร็ว ส่งผลให้ค่า Error ในแบบจำลองตกลงไปแตะระดับ -80 W/m² ในช่วงมุม 60 ถึง 85 องศา

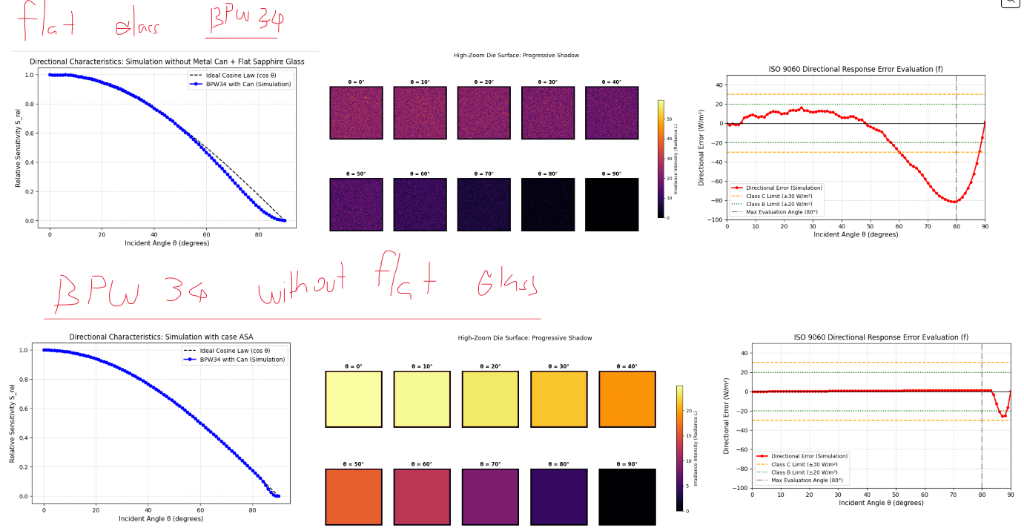
[picture p17: figure]

รูปที่ 3.5 ผลการจำลองการตอบสนองเชิงมุมและ Heatmap ของ BPW 34 พร้อมการประเมินความคลาดเคลื่อน ISO 9060

จากการเปรียบเทียบพฤติกรรมเชิงมุมของทั้ง BPX 61 และ BPW 34 ภายใต้เงื่อนไขที่มีและไม่มีกระจกหน้าต่าง สามารถสรุปผลการตอบสนองเชิงมุมสัมพัทธ์ (Relative Angular Response) ที่มุมตกกระทบสำคัญต่างๆ ได้ดังแสดงในตารางที่ 3.5

ตารางที่ 3.5 การเปรียบเทียบผลการจำลองเชิงมุม: BPX 61 vs BPW 34

มุมตกกระทบ (θ) | BPX 61 (ไม่มีกระจก) | BPX 61 (มีกระจก Schott) | BPW 34 (มีกระจกแซฟไฟร์)
0° (ตั้งฉาก) | 1.000 (ปกติ) | 1.000 (ปกติ) | 1.000 (ปกติ)
30° | 0.852 (ตามสเปก) | 0.830 (เริ่มเบี่ยงเบน) | 0.860 (ตามกฎโคไซน์)
44° | 0.680 (รับแสงได้) | 0.000 (ตัดแสง 100% เพี้ยนหนัก) | 0.710 (รับแสงได้ปกติ)
62° | 0.050 (เริ่มตัดแสงตามสเปก) | 0.000 (มืดสนิท) | 0.450 (รับแสงได้ปกติ)
75° | 0.000 (มืดสนิท) | 0.000 (มืดสนิท) | 0.220 (มี Fresnel Reflection Drop)

3.3.3 ข้อสรุปทางวิศวกรรม: เหตุผลความจำเป็นที่ต้องทำการทดสอบจริงในห้องปฏิบัติการ

ผลจากการจำลองทางทัศนศาสตร์ชี้ให้เห็นประเด็นสำคัญอย่างยิ่งว่า: 'การเพิ่มกระจกครอบไม่ว่าจะในตัวถัง TO-39 หรือตัวถังแบน ทำให้พฤติกรรมของแสงในแบบจำลองคอมพิวเตอร์เกิดความคลาดเคลื่อนเพี้ยนไปจากค่าสเปกชีตหรือทฤษฎีอุดมคติเป็นอย่างมาก' การจำลองทางคณิตศาสตร์มีข้อจำกัดในการจำลองการสะท้อนหลายชั้น (Multiple Internal Reflections) และการกระเจิงของแสงที่ผิวสัมผัสจริง ความจริงทางวิศวกรรมจึงไม่สามารถสรุปได้ด้วยโปรแกรมจำลองเพียงอย่างเดียว นี่จึงเป็นเหตุผลสำคัญที่คณะผู้จัดทำจำเป็นต้องออกแบบระเบียบวิธีการทดลองเพื่อนำอุปกรณ์จริงเข้าทดสอบในห้องปฏิบัติการทางทัศนศาสตร์จริง (Empirical Laboratory Validation) เพื่อให้ได้ข้อมูลจริงที่ถูกต้องที่สุด

3.4 การออกแบบข้อเสนอระเบียบวิธีการทดลองจริงทางทัศนศาสตร์

จากผลการจำลองทางทัศนศาสตร์ในหัวข้อ 3.3 ที่ค้นพบความผิดเพี้ยนของการตอบสนองเชิงมุมเมื่อเพิ่มกระจกหน้าต่าง คณะผู้จัดทำตระหนักดีว่าการยืนยันพฤติกรรมทางกายภาพที่แท้จริงไม่สามารถสรุปได้ด้วยโปรแกรมจำลองคอมพิวเตอร์เพียงอย่างเดียว แต่จำเป็นต้องนำชิ้นงานจริงเข้าทดสอบในห้องปฏิบัติการทางทัศนศาสตร์ อย่างไรก็ดี เพื่อให้การดำเนินงานสอดคล้องกับความเป็นไปได้เชิงปฏิบัติและความพร้อมของเครื่องมือในสถาบัน คณะผู้จัดทำจึงได้จัดทำ 'ข้อเสนอระเบียบวิธีการทดลอง (Proposed Experimental Methodology)' เพื่อนำเข้าขอรับคำปรึกษาและข้อชี้แนะจากอาจารย์ที่ปรึกษาและคณาจารย์ภาควิชาฟิสิกส์ คณะวิทยาศาสตร์ สจล. โดยได้วางแผนครอบคลุมทั้งแนวทางในอุดมคติ (Ideal Setup) และแนวทางสำรองเชิงปฏิบัติหรือชุดแสวงเครื่อง (Practical Contingency Setup) ที่สามารถจัดหาและสร้างขึ้นได้เองอย่างสมเหตุสมผลทางฟิสิกส์ ดังรายละเอียดต่อไปนี้

3.4.1 ชุดการทดลองที่ 1: การวัดค่าการส่องผ่านสเปกตรัมด้วย Vernier LabQuest 2 Spectrometer (350–900 nm)

การทดสอบนี้มีวัตถุประสงค์เพื่อตรวจสอบคุณสมบัติการส่องผ่านแสง (Spectral Transmittance: %T) ของแผ่นกระจกแซฟไฟร์สังเคราะห์ (Synthetic Sapphire Optical Window) ความหนา 1.0 mm เทียบกับอากาศเปล่า (Baseline) ว่ามีค่าการส่องผ่านคงที่และราบเรียบ (Flat) ครอบคลุมย่านความไวแสงของซิลิคอนไดโอด BPW 34 หรือไม่ โดยตรวจสอบว่ามีระลอกคลื่นการแทรกสอด (Fabry-Pérot Fringes) หรือการดูดกลืนแสงที่ไม่คาดคิดเกิดขึ้นหรือไม่

จากการสำรวจเครื่องมือในห้องปฏิบัติการภาควิชาฟิสิกส์ คณะวิทยาศาสตร์ สจล. พบว่ามีชุดตรวจวัดสเปกตรัม 'Vernier LabQuest 2 Connected Science System' ร่วมกับหัววัดสเปกโตรมิเตอร์ (Vernier Spectrometer พร้อมโพรบใยแก้วนำแสง Optical Fiber) ซึ่งมีขอบเขตการตรวจวัดครอบคลุมช่วงความยาวคลื่น 350.1 nm ถึง 899.7 nm ดังแสดงในรูปที่ 3.6 โดยครอบคลุมทั้งย่านแสงที่ตามองเห็น (Visible) และเข้าสู่ย่านอินฟราเรดย่านใกล้ (Near-Infrared: NIR) ซึ่งเป็นช่วงตอบสนองหลักของซิลิคอนไดโอด BPW 34 ได้อย่างสมบูรณ์ ทำให้ข้อเสนอนี้มีความเป็นไปได้จริง 100% ในเชิงทรัพยากรห้องปฏิบัติการ โดยมีระเบียบวิธีทดสอบดังนี้:

1. การเตรียมเครื่องมือ: เปิดเครื่อง Vernier LabQuest 2 เชื่อมต่อหัววัดสเปกโตรมิเตอร์และโพรบใยแก้วนำแสง (Optical Fiber Probe)

2. การวัดเส้นอ้างอิง (Baseline): จัดแนวหัวโพรบใยแก้วนำแสงรับแสงคงที่จากหลอดกำเนิดแสง และทำการบันทึกสเปกตรัมเส้นฐานอ้างอิง I_0(λ) (100% Baseline) ในช่วง 350.1 ถึง 899.7 nm

3. การวัดชิ้นงานจริง: นำแผ่นกระจกแซฟไฟร์สังเคราะห์มาติดตั้งกั้นขวางหน้าปลายโพรบใยแก้วนำแสงในแนวตั้งฉาก แล้วบันทึกสเปกตรัมแสงที่ส่องผ่าน I(λ)

4. การประมวลผลข้อมูล: ประมวลผลคำนวณค่าร้อยละการส่องผ่าน %T(λ) = [I(λ) / I_0(λ)] × 100% และส่งออกไฟล์ข้อมูลตาราง (.csv) ผ่านพอร์ต USB ของ LabQuest 2 เพื่อนำมาพล็อตเปรียบเทียบกับค่า 85–88% ในแบบจำลองทางทัศนศาสตร์

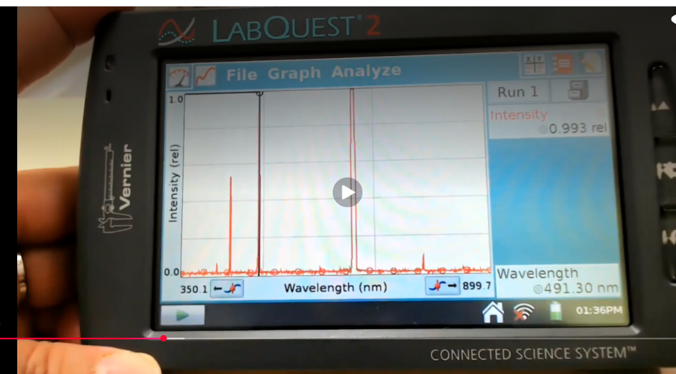
[picture p18: figure]

รูปที่ 3.6 หน้าจอแสดงผลการวัดสเปกตรัมความยาวคลื่น 350.1–899.7 nm ของชุด Vernier LabQuest 2 ในห้องปฏิบัติการฟิสิกส์

3.4.2 ชุดการทดลองที่ 2: การวัดการตอบสนองเชิงมุมบนแท่นหมุน (Directional Cosine Response Test)

วัตถุประสงค์เพื่อตรวจสอบพฤติกรรมการตอบสนองต่อมุมตกกระทบของแสง (Cosine Response) ของหัววัด BPW 34 ทั้งกรณีมีและไม่มีกระจกหน้าต่าง เพื่อพิสูจน์การดรอปของกระแสที่มุมชันเนื่องจากปรากฏการณ์ Fresnel Reflection ดังที่พบในการจำลองทางทัศนศาสตร์ ระบบการทดสอบได้รับการออกแบบโดยแบ่งเป็นส่วนประกอบหลักดังนี้ (รูปที่ 3.7):

1) แท่นหมุนปรับมุมองศา (Rotation Stage): อาศัยแท่นหมุนเชิงแสงแบบมือหมุน (Manual Optical Rotation Stage พร้อมสเกล Vernier) ซึ่งเป็นอุปกรณ์มาตรฐานบนโต๊ะเชิงแสง (Optical Table) ของห้องปฏิบัติการฟิสิกส์ โดยจะจัดทำชุดยึดหัววัด (Test Jig) เพื่อให้ระนาบผิวรับแสงของชิปไดโอดและกระจกแซฟไฟร์วางอยู่ในแนวแกนหมุนกึ่งกลางพอดี (Co-axial Alignment) เพื่อป้องกันการเยื้องศูนย์ขณะปรับมุมตั้งแต่ 0° ถึง 85°

2) การจัดเตรียมแหล่งกำเนิดแสงและข้อเสนอลำแสงขนาน (Light Source & Collimation Strategy): คณะผู้จัดทำได้วางแนวทางไว้ 2 รูปแบบ เพื่อนำเสนอขอรับความเห็นชอบจากอาจารย์ที่ปรึกษาตามความเหมาะสมของอุปกรณ์ในภาควิชา:

• แนวทางตามอุดมคติ (Ideal Scenario): หากห้องปฏิบัติการมีชุดเครื่องจำลองแสงอาทิตย์ (Solar Simulator) หรือชุดแหล่งกำเนิดแสงซีนอนร่วมกับเลนส์คอลลิเมเตอร์ (Collimating Lens System) พร้อมใช้งาน จะใช้ลำแสงขนานมาตรฐานนี้ส่องเข้าหาแท่นหมุนโดยตรง

• แนวทางสำรองเชิงปฏิบัติหรือชุดแสวงเครื่อง (Practical Contingency / DIY Setup): ในกรณีที่ไม่มีชุดกำเนิดลำแสงขนานเฉพาะทาง คณะผู้จัดทำเสนอให้ใช้ 'หลอดทังสเตน-ฮาโลเจน (Tungsten-Halogen Lamp ขนาด 12V 50W หรือ 100W)' จ่ายไฟด้วย Bench Power Supply กระแสตรงคงที่ เพื่อให้ความเข้มแสงนิ่งสนิท ไร้การกระพริบตามความถี่ไฟบ้าน 50 Hz โดยมีข้อได้เปรียบทางฟิสิกส์คือ หลอดทังสเตนเปล่งแสงแบบการแผ่รังสีวัตถุดำ (Blackbody Radiation ที่อุณหภูมิ 2,800–3,000 K) ซึ่งให้สเปกตรัมที่ต่อเนื่องราบเรียบตั้งแต่ช่วงคลื่นตามองเห็นจนถึงอินฟราเรดย่านใกล้ (350–2,000+ nm) สอดคล้องกับย่านการทำงานของซิลิคอนไดโอดได้เป็นอย่างดี ปราศจากเส้นสเปกตรัมแหลมแบบหลอดฟลูออเรสเซนต์หรือ LED

• การสร้างลำแสงขนานเสมือนด้วยระยะห่าง (Quasi-parallel Beam via Distance): คณะผู้จัดทำประยุกต์ใช้หลักการทางเรขาคณิต โดยติดตั้งหลอดทังสเตนไว้ที่ระยะห่าง d ≥ 1.5 ถึง 2.0 เมตรจากแท่นหมุน ด้วยขนาดชิป BPW 34 ที่เล็กเพียง 2.65 × 2.65 mm มุมกวาดเบี่ยงเบนของลำแสง (Subtended Divergence Angle) จะมีค่าเพียง arctan(2.65 / 2000) ≈ 0.076° ซึ่งน้อยกว่า 0.1° มาก ทำให้ลำแสงที่เดินทางมาตกกระทบหน้าสัมผัสเซนเซอร์มีความขนานเสมือนจริงตามทฤษฎี โดยไม่จำเป็นต้องพึ่งพาเลนส์รวมแสงราคาแพง

• การป้องกันแสงสะท้อนและแสงกระเจิง (Stray Light & Baffle System): ทำการทดสอบในห้องมืดสนิท และติดตั้งท่อบังแสงทรงกระบอก (Baffle Tube) บุผิวด้านในด้วยวัสดุสีดำด้านหน้าหลอดไฟและเซนเซอร์ เพื่อกำจัดแสงสะท้อนจากผนังห้องหรือพื้นโต๊ะทดลองไม่ให้เล็ดลอดเข้ามาส่งผลต่อการวัดที่มุมเฉียง

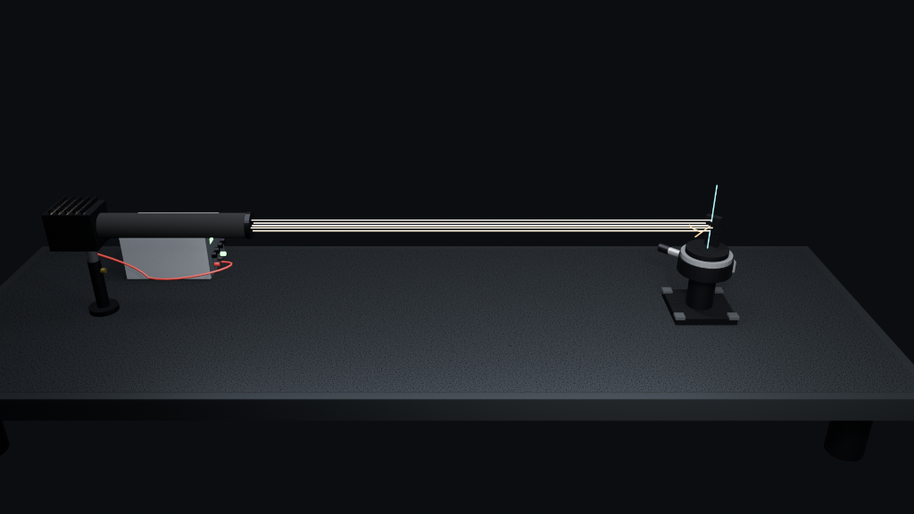
[picture p19: figure]

(ก) แบบจำลองสามมิติ (Perspective View) แสดงการจัดวางโคมหลอดทังสเตน ท่อ Baffle และแท่นหมุนบน Optical Table

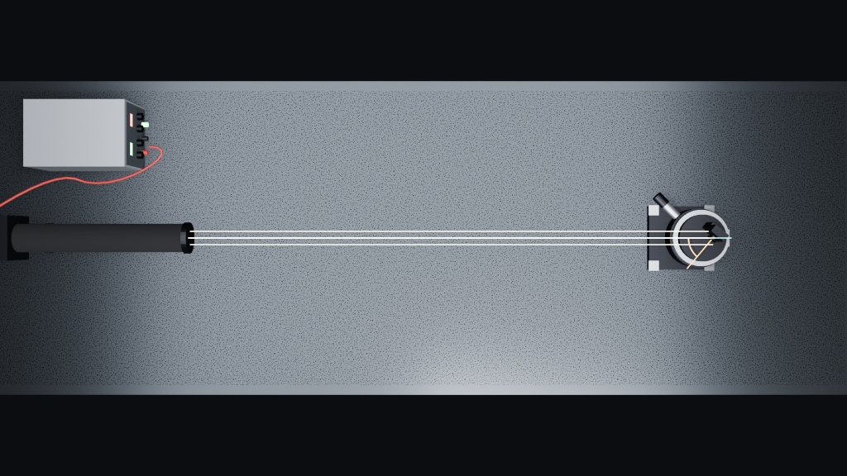
[picture p20: figure]

(ข) แบบจำลองมุมมองระนาบบน (Top-down Plan View) แสดงแนวลำแสงขนานและการวัดมุมตกกระทบ θ

รูปที่ 3.7 แบบจำลองชุดแท่นหมุนวัดการตอบสนองเชิงมุม (Goniometer Cosine Test Jig) พร้อมข้อเสนอชุดกำเนิดแสงแสวงเครื่อง

ข้อเสนอระเบียบวิธีการทดลองทั้งสองชุดนี้ ได้รับการออกแบบขึ้นเพื่อเป็นกรอบการดำเนินงานอย่างรอบคอบ โดยคณะผู้จัดทำจะนำแผนงานดังกล่าวเข้าปรึกษาอาจารย์ที่ปรึกษาและอาจารย์ประจำห้องปฏิบัติการฟิสิกส์ เพื่อร่วมกันประเมิน ความพร้อมของเครื่องมือ และเลือกแนวทางการทดลองที่เหมาะสมและเป็นไปได้จริงมากที่สุดสำหรับการดำเนินงานโครงงานในภาคการศึกษาถัดไป

3.5 สถานะปัจจุบันและการออกแบบแผ่นวงจรพิมพ์ 4 เลเยอร์ (Custom 4-Layer PCB) สู่การผลิตจริง

สรุปสถานะความก้าวหน้าและการพัฒนาฮาร์ดแวร์ของโครงงาน Capstone Project 1 ณ ปัจจุบัน:

1. การพิสูจน์วงจรต้นแบบ: วงจรภาคอ่านสัญญาณได้รับการพิสูจน์การทำงานจริงบน Breadboard และตัวต้นแบบบัดกรีมือเรียบร้อยแล้ว สามารถอ่านสัญญาณ ADC 24 บิตและตอบสนองต่อสเปกตรัมแสงต่างๆ ได้อย่างแม่นยำ พร้อมทั้งค้นพบปัญหา Parasitic Trace Offset และ USB Dropout ซึ่งได้รับการแก้ไขด้วยสวิตชิ่ง 5.2 V

2. การแก้ไขด้านความเสถียร: ค้นพบปัญหาความไม่เสถียรของ REF5045 อันเนื่องมาจากค่า ESR ของตัวเก็บประจุ และได้วางแผนแก้ปัญหาอย่างถูกต้องโดยการสั่งซื้อ Low-ESR Ceramic Cap (10 µF X7R) เพื่อรักษา Phase Margin ของลูปควบคุมแรงดัน

3. กรอบการวิจัยทางแสงสู่ Capstone 2: ผลการจำลองทัศนศาสตร์พิสูจน์ชัดเจนว่า BPW 34 ให้การตอบสนองเชิงมุมเหนือกว่า BPX 61 และค้นพบประเด็นความผิดเพี้ยนจากการใส่กระจกหน้าต่าง ซึ่งเป็นที่มาของการออกแบบระเบียบวิธีวิจัยเพื่อนำเข้าทดสอบจริงในห้องปฏิบัติการของคณะวิทยาศาสตร์ในโครงงาน 2

4. การออกแบบแผ่นวงจรพิมพ์ 4 เลเยอร์คู่ขนาน (Custom Dual-Variant PCB): เพื่อขจัดปัญหาความต้านทานแฝงและสัญญาณรบกวนจากการต่อสายลอย คณะผู้จัดทำได้ออกแบบแผ่นวงจรพิมพ์ 4 เลเยอร์ (Custom 4-Layer Circular Sensor Head PCB) รุ่น 'V1.1 L1 by Tachin' บนโปรแกรม KiCad 10.0 โดยจัดสรรโครงสร้างแบบคู่ขนาน 2 รูปแบบ ได้แก่ รุ่น L1_Analog (สำหรับ BPX 61 ในตัวถัง TO-39 Can) และรุ่น L1_Analog_BPW34 (สำหรับ BPW 34 ในตัวถัง Flat DIL Plastic) ทั้งนี้ จากการตรวจสอบเอกสารข้อมูลทางเทคนิคของ ams OSRAM ยืนยันว่าเซนเซอร์ทั้งสองรุ่นใช้เนื้อชิปซิลิคอน (Active Chip Die) ขนาดเดียวกันเป๊ะ คือ 2.65 × 2.65 mm² (พื้นที่รับแสง 7.02 mm²) จึงมีคุณสมบัติทางไฟฟ้าและสเปกตรัมเท่ากันทุกประการ ทำให้การออกแบบแผ่นวงจรคู่ขนานนี้เป็นการทดลองแบบควบคุมตัวแปร (Controlled Experiment) ที่สมบูรณ์แบบเพื่อเปรียบเทียบผลของตัวถังและหน้าต่างทางทัศนศาสตร์อย่างแท้จริง โดยทั้งสองรุ่นผ่านการตรวจ DRC 100% ไร้ข้อผิดพลาด (0 Violations / 0 Unconnected items) พร้อมส่งผลิตโรงงาน (PCBWay) สำหรับใช้ใน Capstone 2 ต่อไป

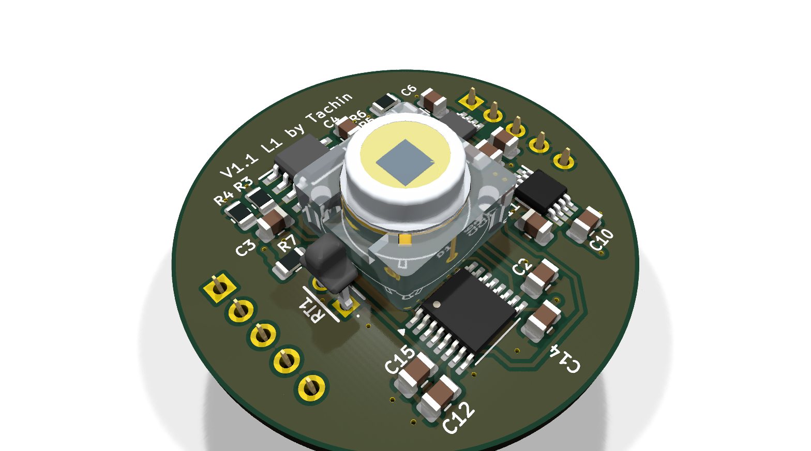
[picture p21: figure]
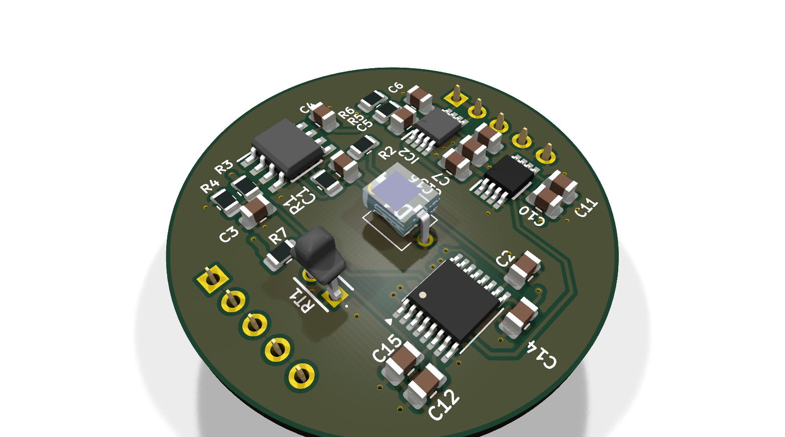
[picture p22: figure]

(ก) รุ่นที่ 1: ตัวถังโลหะ TO-39 Can (BPX 61) | (ข) รุ่นที่ 2: ตัวถังพลาสติกแบน Flat DIL (BPW 34)

รูปที่ 3.13 ภาพจำลอง 3 มิติของแผ่นวงจรพิมพ์ 4 เลเยอร์คู่ขนาน (Custom 4-Layer PCB: BPX 61 vs BPW 34)

เอกสารอ้างอิง
(References)

[1] International Organization for Standardization. (2018). Solar energy — Specification and classification of instruments for measuring hemispherical solar and direct solar radiation (ISO Standard No. 9060:2018).

[2] ams-OSRAM AG. (2023). BPX 61 Silicon PIN Photodiode in Metal Can TO39 Package [Datasheet]. Version 1.6, Document No. Q62705P0025.

[3] ams-OSRAM AG. (2023). BPW 34 Silicon PIN Photodiode in Flat Clear Plastic Package [Datasheet]. Version 1.6.

[4] Texas Instruments. (2016). ADS1220 4-Channel, 2-kSPS, Low-Power, 24-Bit ADC with Integrated PGA and Reference [Datasheet]. SBAS501B.

[5] Texas Instruments. (2018). REF50xx Low-Noise, Very Low Drift, Precision Voltage Reference [Datasheet]. SBOS410I.

[6] Thinking Electronic Industrial Co., Ltd. (2022). TTC03 Series Epoxy Coated Type NTC Thermistor (TTC3A103F39HAEY) Specifications [Datasheet].

[7] Hecht, E. (2017). Optics (5th ed.). Pearson Education. (Chapters on Fresnel Reflection and Snell's Law).

[8] World Meteorological Organization (WMO). (2021). Guide to Instruments and Methods of Observation (WMO-No. 8), Volume I — Measurement of Radiation.

ภาคผนวก
(Appendices)

ภาคผนวก ก รายการอุปกรณ์ต้นแบบ (Bill of Materials - BOM)

รายการอุปกรณ์และชิ้นส่วนอิเล็กทรอนิกส์ทั้งหมดที่ใช้ในการทดสอบวงจรต้นแบบบน Breadboard และเตรียมประกอบลงบนแผงวงจรอเนกประสงค์ (Perfboard) สำหรับโครงงาน Project 1:

อุปกรณ์ / ไอซี | เบอร์อุปกรณ์ / Part Number | คุณสมบัติสำคัญ | สถานะการใช้งาน
Silicon Photodiode | OSRAM BPW 34 | Flat Clear Mold, 7.02 mm² Active Area | ใช้งานจริงบน Breadboard
Alternative Detector | OSRAM BPX 61 | TO-39 Metal Can, แผ่นชิป 7.02 mm² | จัดหาแล้วสำหรับทดสอบเปรียบเทียบ
Optical Window | Synthetic Sapphire | ความแข็งระดับ 9 Mohs, หนา 1 mm | พร้อมสำหรับการทดสอบแล็บ
Transimpedance Op-Amp | TI OPA380AID | Zero-Drift, Offset ต่ำมาก, R_TIA = 2.2 kΩ | วงจรขยายกระแสแสง TIA
24-bit Delta-Sigma ADC | TI ADS1220IPW | TSSOP-16 พร้อมบอร์ดแปลง, 4-ch MUX, Low-noise PGA | ใช้งานจริงบน Breadboard
Precision Reference | TI REF5045AID | SOIC-8 พร้อมบอร์ดแปลง, 4.500 V, 3 ppm/°C | ใช้งานจริงบน Breadboard
Microcontroller Unit | ESP32-C6 Super Mini | RISC-V 32-bit, Wi-Fi 6, SPI Master, Web Server | ใช้งานจริงบน Breadboard
NTC Thermistor | Thinking TTC3A103F39HAEY | 10 kΩ ±1% ที่ 25°C, ค่า B25/85 = 3950 K | ใช้งานจริงบน Breadboard (จัดหาในไทย)
Decoupling Capacitor C10 | 10 µF 16V X7R | Low-ESR Ceramic Capacitor | สั่งซื้อแล้ว (กำหนดส่งมอบ 30 ต.ค.)
Regulated Power Supply | DC Switching 5.2V | แรงดันคงที่ 5.20 V, ก้าวข้าม Dropout ของ REF5045 | ใช้งานจริงบน Breadboard
