tachin-r/Pyranometer_Over_engineering/Report_doc/image/BPW34 without glass.png

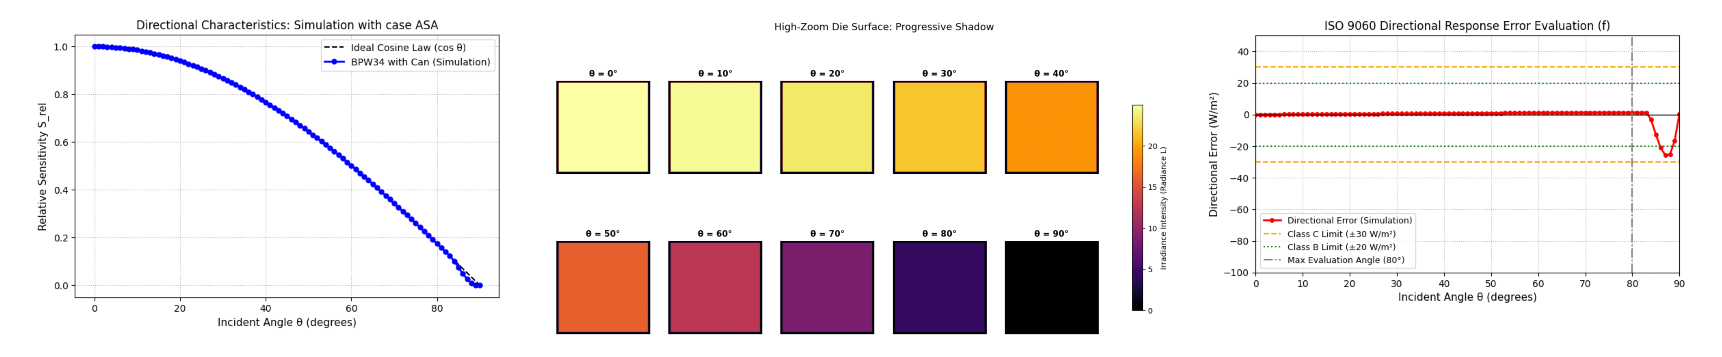
Report_doc/image/BPW34 without glass.png
