tachin-r/Pyranometer_Over_engineering/Report_doc/image/BPX61 with glass.png

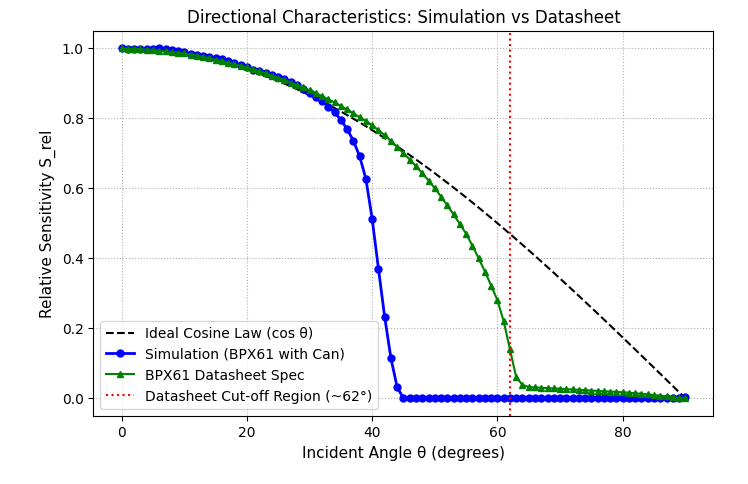
Report_doc/image/BPX61 with glass.png
