tachin-r/Pyranometer_Over_engineering/Report_doc/image/BPX61 without glass.png

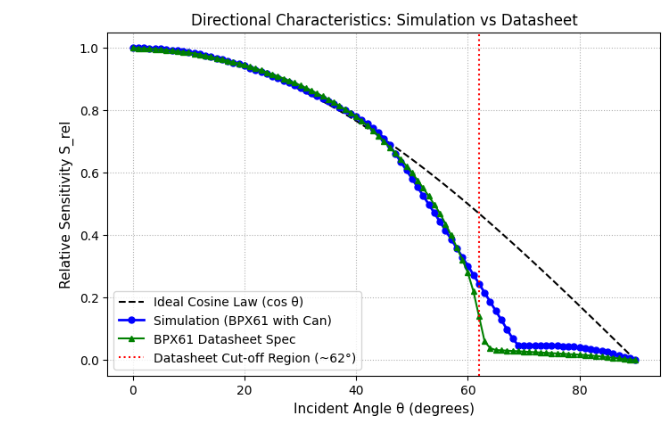
Report_doc/image/BPX61 without glass.png
