tachin-r/Pyranometer_Over_engineering/Report_doc/image/crop_arduino3.png

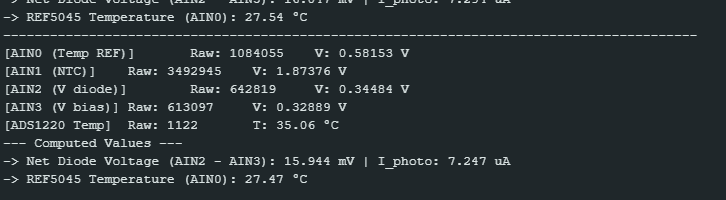
Report_doc/image/crop_arduino3.png
