tachin-r/Pyranometer_Over_engineering/Report_doc/image/pcb_3d_render_top.png

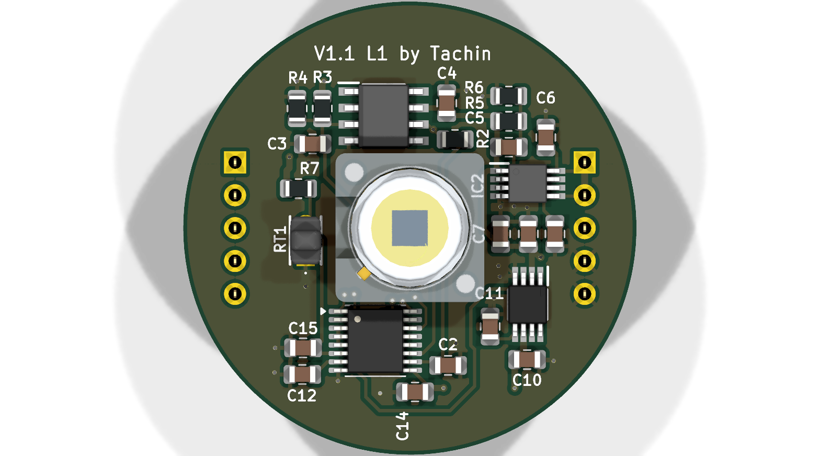
Report_doc/image/pcb_3d_render_top.png
