tachin-r/Pyranometer_Over_engineering/Report_doc/image/pcb_bpw34_3d_render_top.png

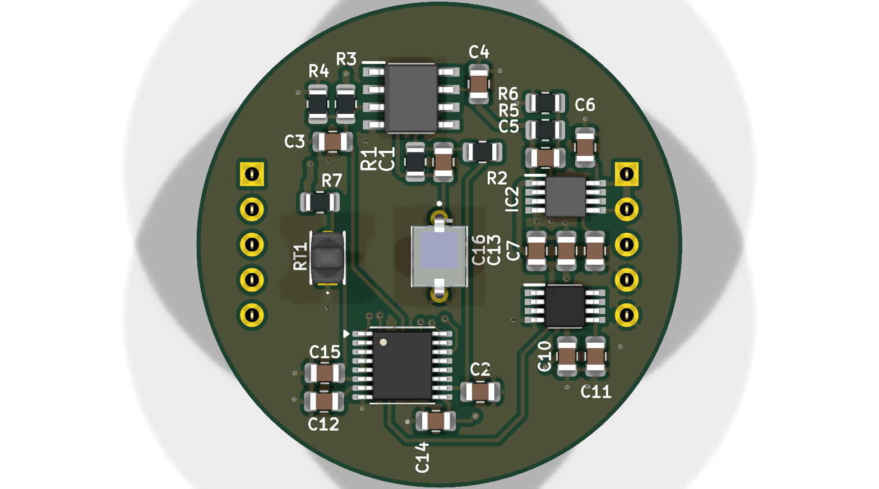
Report_doc/image/pcb_bpw34_3d_render_top.png
