tachin-r/Pyranometer_Over_engineering/Report_doc/photodiode_iv_curve.png

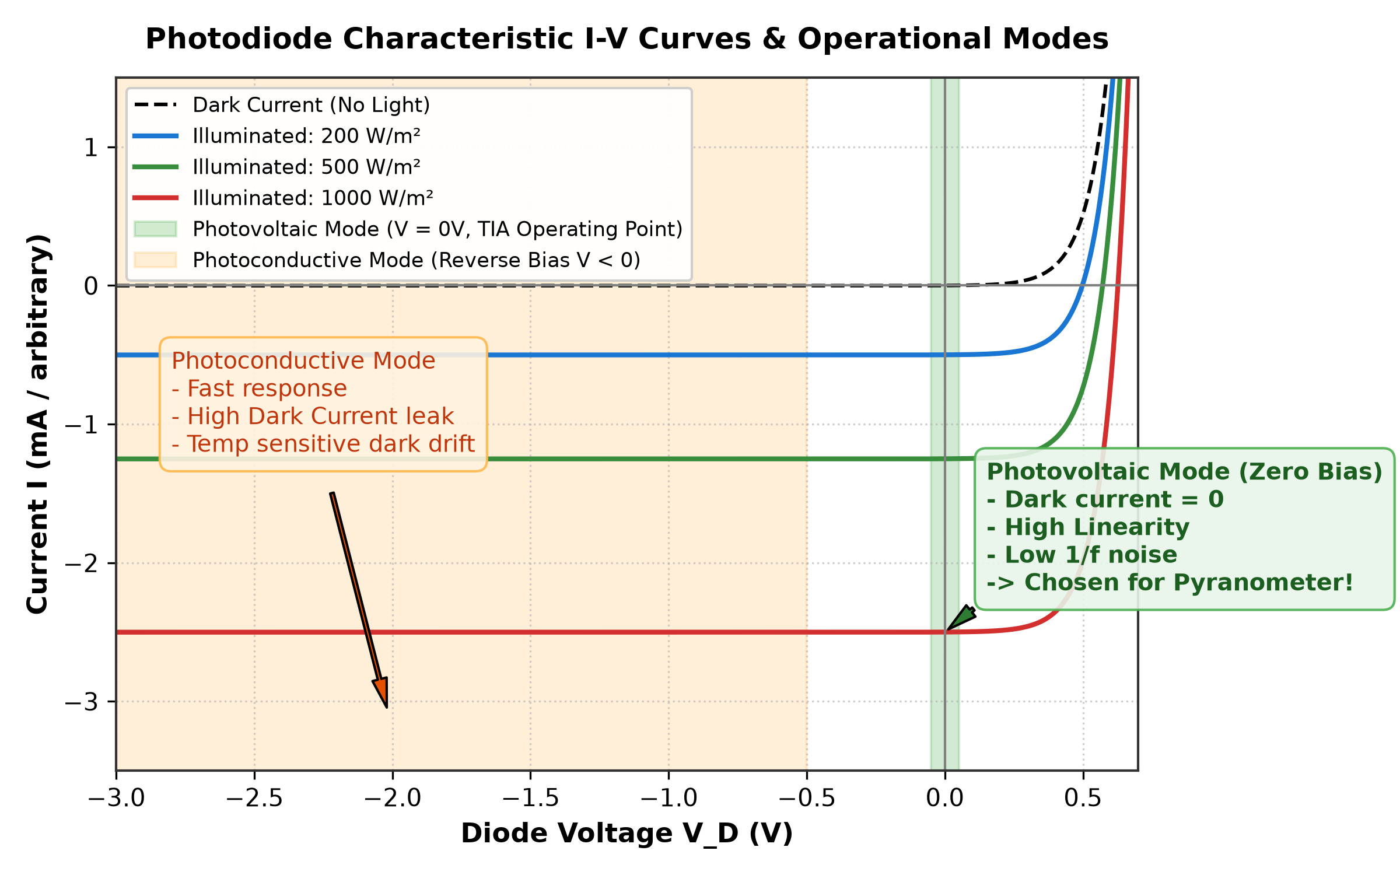
Report_doc/photodiode_iv_curve.png
