tachin-r/Pyranometer_Over_engineering/Report_doc/tia_circuit_architecture.png

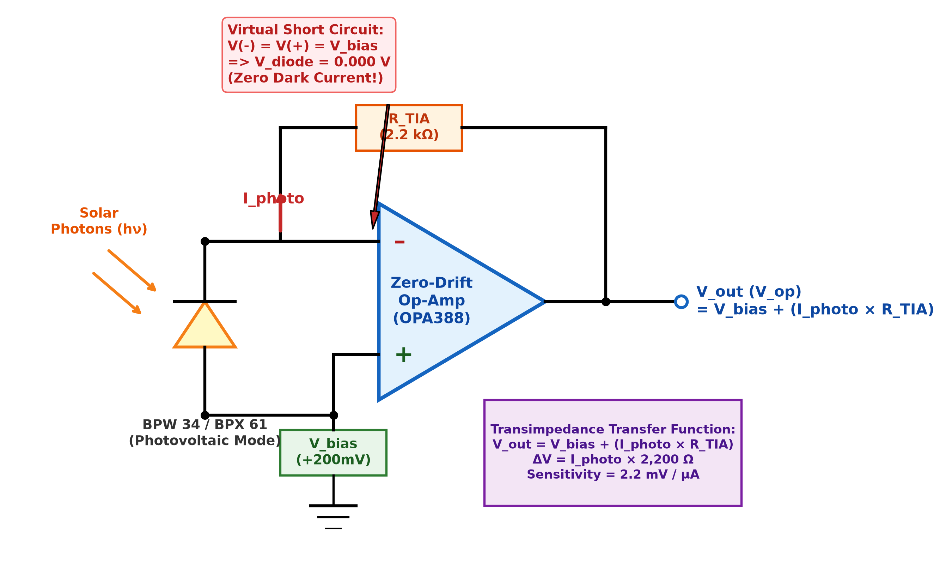
Report_doc/tia_circuit_architecture.png
