tachin-r/Pyranometer_Over_engineering/Report_doc/PHOTO_GUIDE_PERFBOARD.md

# 📷 คู่มือการเตรียมและแทรกรูปภาพในเล่มรายงานความก้าวหน้า Project 1
## สำหรับโครงงาน: การพัฒนาระบบวัดการแผ่รังสีแสงอาทิตย์ความแม่นยำสูง (High-Precision Pyranometer)

เอกสารนี้สรุปตำแหน่งที่ต้องใส่รูปภาพทั้งหมดในเล่มรายงานฉบับล่าสุด (`69_IoT_Project1_Report_Updated.docx`) โดยจัดกลุ่มชัดเจนระหว่าง **ภาพที่ต้องถ่ายจากของจริง / แคปจากจอคอม** กับ **ภาพไดอะแกรม / Schematic จากโปรแกรม** เพื่อให้เตรียมภาพได้สะดวกที่สุดครับ

---

### 🌟 สรุปภาพไฮไลท์สำคัญที่ต้องถ่ายจริง / แคปจากหน้าจอ (8 ภาพหลัก)

| ลำดับรูป | หัวข้อในเล่ม | ชื่อรูปภาพ | คำแนะนำในการถ่ายภาพ / เตรียมภาพ |
| :---: | :--- | :--- | :--- |
| **รูปที่ 2.5** | บทที่ 2 (2.5) | **📷 กราฟ Directional Characteristics: Simulation with Metal Can** | ภาพกราฟเปรียบเทียบ Ideal Cosine (เส้นประสีดำ) กับ BPX61 with Can (เส้นสีน้ำเงิน) ที่มุมตกกระทบตัดแสงที่ 70° |
| **รูปที่ 2.6** | บทที่ 2 (2.5) | **📷 ภาพ High-Zoom Die Surface: Progressive Shadow by TO-39 Can** | ภาพ Heatmap 10 ช่อง (θ = 0° ถึง 90°) แสดงเงาขอบกระป๋อง TO-39 บดบังผิว Die ซิลิคอน |
| **รูปที่ 2.7** | บทที่ 2 (2.5) | **📷 Polar Plot คุณลักษณะเชิงทิศทางจาก Datasheet BPX61** | ภาพ Polar Plot จาก Datasheet ของ Osram BPX61 ที่แสดงมุมตัดแสง 60°–70° สอดคล้องกับ Simulation |
| **รูปที่ 3.4** | บทที่ 3 (3.2.2) | **📷 ภาพถ่ายวงจรต้นแบบจริงบน Breadboard** | ถ่ายภาพแผงเบรดบอร์ดขณะกำลังทดลอง มีบอร์ดแปลง SOIC-8, สายจัมเปอร์ และมัลติมิเตอร์/โพรบวัดขา REF5045 |
| **รูปที่ 3.5** | บทที่ 3 (3.2.2) | **📷 ภาพถ่ายบอร์ด Perfboard มุมมองด้านบน (Top View)** | วางบอร์ดไข่ปลาบนพื้นเรียบสว่าง ถ่ายมุมตั้งฉาก 90° ให้เห็นไอซี, ซ็อกเก็ต, เทอร์มินัลบล็อก และ C10 (10µF) ชิดขาไอซี |
| **รูปที่ 3.6** | บทที่ 3 (3.2.2) | **📷 ภาพถ่ายบอร์ด Perfboard มุมมองด้านล่าง (Bottom View)** | ถ่ายรูปลายบัดกรีด้านหลังบอร์ดไข่ปลา ซูมให้เห็นจุดบัดกรีเงาสวยงาม การเดินสายแบบ Point-to-Point และ Star Ground |
| **รูปที่ 3.11** | บทที่ 3 (3.3.3) | **📷 ภาพหน้าจอ Web UI Prototype & การปักหมุด Google Maps** | แคปเจอร์หน้าจอเว็บแอปพลิเคชัน แสดงกราฟแสง, ช่องกรอกพิกัดจาก Google Maps และค่ามุมดวงอาทิตย์ที่คำนวณได้ |
| **รูปที่ 4.3** | บทที่ 4 (4.4) | **📷 ภาพหน้าจอแสดงข้อมูลดิบผ่าน Serial Monitor** | แคปเจอร์หน้าต่าง Arduino IDE / VSCode Serial Monitor หรือ Terminal แสดง Raw Counts แสงและอุณหภูมิ NTC ที่ส่งออกมา |

---

### 📐 รายการภาพไดอะแกรม วงจร Schematic และทฤษฎี (ดึงจากไฟล์ในโปรเจกต์)

| ลำดับรูป | หัวข้อในเล่ม | ชื่อรูปภาพ | แหล่งที่มา / วิธีเตรียม |
| :---: | :--- | :--- | :--- |
| **รูปที่ 1.1** | บทที่ 1 (1.1) | แผนภาพสถาปัตยกรรมระบบโดยรวม (Conceptual Architecture) | เซนเซอร์ $\rightarrow$ L1_Analog $\rightarrow$ L2_MCU $\rightarrow$ Web App |
| **รูปที่ 2.1** | บทที่ 2 (2.1) | วงจรสมมูลของ Photodiode และการตอบสนองต่อแสงอาทิตย์ | วงจรสมมูลโฟโตไดโอด (I_ph, R_sh, C_j, R_s) |
| **รูปที่ 2.2** | บทที่ 2 (2.2) | วงจรแบ่งแรงดันของ NTC Thermistor 10 kΩ และกราฟ R-T | วงจร Voltage Divider ของ NTC และกราฟความสัมพันธ์ตาม Beta 3435 K |
| **รูปที่ 2.3** | บทที่ 2 (2.3) | โครงสร้างภายในของไอซีแปลงสัญญาณ ADC 24 บิต ADS1220 | แคปจาก Datasheet TI ADS1220 หน้า Functional Block Diagram |
| **รูปที่ 2.4** | บทที่ 2 (2.4) | ผังขาและวงจรภายในของไอซีแรงดันอ้างอิง REF5045 | ผังขา SOIC-8 ไฮไลท์ขา 5 (Trim/NR จุด High-Z) และขา 6 (VOUT) |
| **รูปที่ 2.8** | บทที่ 2 (2.6) | แผนภูมิห่วงโซ่การสอบกลับได้ (Measurement Traceability Chain) | แผนภูมิการสอบกลับได้จาก SI Units $\rightarrow$ NIMT $\rightarrow$ Working Standard $\rightarrow$ เครื่องมือวัด |
| **รูปที่ 3.1** | บทที่ 3 (3.1) | บล็อกไดอะแกรมสถาปัตยกรรมระบบแบบ Computational Sensing | System Block Diagram แสดงบอร์ด L1, L2, L3 และเลเยอร์ซอฟต์แวร์ |
| **รูปที่ 3.2** | บทที่ 3 (3.2.1) | แผนภาพวงจร (Schematic) บอร์ดขยายสัญญาณแอนะล็อก L1_Analog | Export ภาพจาก `L1_Analog/L1_Analog.kicad_sch` |
| **รูปที่ 3.3** | บทที่ 3 (3.2.2) | ภาพจำลองการต่อวงจรทดสอบขั้นแรกบนเบรดบอร์ด | ไดอะแกรมจำลองการเสียบชิปบน Breadboard และทางเดินกระแสรั่วไหล |
| **รูปที่ 3.7** | บทที่ 3 (3.2.3) | แผนภาพวงจรบอร์ดประมวลผลไมโครคอนโทรลเลอร์ L2_MCU | Export ภาพจาก `L2_MCU/L2_MCU.kicad_sch` |
| **รูปที่ 3.8** | บทที่ 3 (3.2.4) | แผนภาพวงจรบอร์ดจัดการพลังงาน L3_Switching | Export ภาพจาก `L3_Switching/L3_Switching.kicad_sch` |
| **รูปที่ 3.9** | บทที่ 3 (3.3.1) | ผังงานการทำงานของเฟิร์มแวร์ไมโครคอนโทรลเลอร์ (Flowchart) | Flowchart การอ่าน ADC $\rightarrow$ Moving Average $\rightarrow$ Serial Output |
| **รูปที่ 3.10** | บทที่ 3 (3.3.2) | แผนผังการทำงานของอัลกอริทึม Software Cosine & Temperature Correction | ไดอะแกรมการคำนวณ SPA + Google Maps GPS $\rightarrow$ Inversion Model |
| **รูปที่ 3.12** | บทที่ 3 (3.4) | โครงสร้างเปรียบเทียบเซนเซอร์กระป๋อง TO-39 กับ Flat SMD (TEMD5010X01) | ภาพตัดขวางเปรียบเทียบความสูง 4.5 มม. (มีหลุมขอบบัง) กับ 1.12 มม. (แบนราบไร้ขอบ) |
| **รูปที่ 4.1** | บทที่ 4 (4.1) | กราฟเปรียบเทียบเสถียรภาพแรงดันเอาต์พุตของการต่อ C10 ชิดขา REF5045 | ภาพรูปคลื่น Oscilloscope เทียบระหว่างมีและไม่มีตัวเก็บประจุ C10 (10µF) |
| **รูปที่ 4.2** | บทที่ 4 (4.2) | กราฟความคลาดเคลื่อนโคไซน์จากการจำลองเงาเทียบกับฟังก์ชัน Ideal Cosine | กราฟเปอร์เซ็นต์ Cosine Error (%) เทียบกับมุมตกกระทบ $\theta_z$ |

---

### 🛠️ วิธีการนำภาพไปวางในไฟล์ Word:

1. เปิดไฟล์ **`Report_doc/69_IoT_Project1_Report_Updated.docx`** ใน Microsoft Word
2. ในเนื้อหาจะมีกรอบสี่เหลี่ยมเส้นประสีฟ้ากำกับไว้ทุกจุด เช่น:
   ```
   📷 [ จุดแทรกรูปภาพที่ 3.5: ภาพถ่ายวงจรต้นแบบบนแผงวงจรอเนกประสงค์ (Perfboard) มุมมองด้านบน ]
   ```
3. คลิกที่กรอบสี่เหลี่ยมเส้นประ กด **Delete** ลบกล่องออก
4. กด **Insert $\rightarrow$ Pictures** เลือกภาพถ่ายของคุณวางลงไปแทนที่ได้ทันที
5. ปรับขนาดรูปภาพให้อยู่กึ่งกลางหน้ากระดาษอย่างสวยงามครับ!
