tachin-r/Pyranometer_Over_engineering/Report_doc/SOLAR_SIMULATOR_GUIDE.md

# ☀️ คู่มือการติดต่อและเตรียมตัวเข้าใช้เครื่อง Solar Simulator (Solar Light XPS-300)
## ศูนย์ทดสอบและวิเคราะห์เทคโนโลยีขั้นสูง (ATTAC) / Nano Central Laboratory สจล.
**อาคาร 55 พรรษา เฉลิมพระเกียรติ ชั้น 3 คณะเทคโนโลยีการผลิตและนวัตกรรม**

---

## ✉️ 1. ร่างข้อความตอบกลับอีเมล (Copy ไปส่งได้ทันที)

**ถึง:** `Nano Central Laboratory (KMITL)` <nanoinstru@kmitl.ac.th>  
**เรื่อง:** Re: ขอความอนุเคราะห์เข้าใช้งาน / ขอยืมเครื่อง Solar Simulator (Solar Light XPS-300)

```text
เรียน พี่วิษา หอมจันทร์ (ศูนย์ทดสอบและวิเคราะห์เทคโนโลยีขั้นสูง ATTAC)

ขอขอบพระคุณพี่วิษาเป็นอย่างยิ่งครับที่กรุณาตอบรับและติดต่อกลับมา

เบอร์โทรศัพท์ติดต่อของผมคือ:
• โทร: 094-380-7779 (เตชินท์ รัฐวงษา)
(สะดวกรับสายได้ตลอดเวลาทำการครับ)

หากพี่วิษาสะดวก หรือมีเอกสาร/แบบฟอร์มขอใช้บริการที่ต้องกรอกล่วงหน้า ผมสามารถเดินเข้าไปพบพี่วิษาที่ศูนย์ ATTAC ชั้น 3 อาคาร 55 พรรษา เพื่อนำตัวอย่างบอร์ดเซนเซอร์ไปให้ดูขนาด และรับคำแนะนำขั้นตอนการขอใช้เครื่องได้เลยนะครับ

ขอขอบพระคุณเป็นอย่างสูงครับ

เตชินท์ รัฐวงษา (รหัสนักศึกษา 66010296)
หลักสูตรสองปริญญา:
- วิศวกรรมศาสตรบัณฑิต (วิศวกรรมระบบไอโอทีและสารสนเทศ)
- วิทยาศาสตรบัณฑิต (ฟิสิกส์อุตสาหกรรม)
คณะวิศวกรรมศาสตร์ สถาบันเทคโนโลยีพระจอมเกล้าเจ้าคุณทหารลาดกระบัง
โทร: 094-380-7779
```

---

## 📞 2. บทพูดและคำถามตอนคุยโทรศัพท์ (Phone Call Cheatsheet)

### 🔹 การแนะนำตัว:
> *"สวัสดีครับพี่วิษา ผม เตชินท์ รัฐวงษา รหัสนักศึกษา 66010296 จากหลักสูตรสองปริญญา IoT และฟิสิกส์อุตสาหกรรมครับ ที่ส่งอีเมลขอใช้เครื่อง Solar Light XPS-300 ครับ"*

---

### 🔹 4 คำถามสำคัญที่ต้องถามพี่เจ้าหน้าที่:

#### คำถามที่ 1: หัววัดอ้างอิงมาตรฐาน (Reference Sensor)
> *"ที่เครื่อง Solar Light XPS-300 มี **Calibrated Reference Cell (หัววัดแสงมาตรฐาน NIST)** ประจำเครื่องที่สามารถอ่านค่าความเข้มแสงจริง (หน่วย $\text{W/m}^2$ หรือ $\text{mW/cm}^2$) เพื่อให้พวกผมนำมาเทียบสเกล Calibration ได้เลยไหมครับ?"*
* **เหตุผล:** เราต้องรู้ว่าเครื่องเขามีหัววัดเทียบให้ไหม ถ้ามี แปลว่าเราไม่ต้องไปหาเช่าหัววัดข้างนอกมาเพิ่ม

#### คำถามที่ 2: การต่อสายไฟและสายสัญญาณ (Cable Pass-through)
> *"ระหว่างที่เปิดโคมแสง Solar Simulator ห้องทดสอบมีช่องให้ร้อยสาย USB หรือสายไฟจากบอร์ดออกมาต่อเข้าโน้ตบุ๊กด้านนอกห้อง เพื่อมอนิเตอร์และบันทึกข้อมูลแบบ Real-time ได้ไหมครับ?"*
* **เหตุผล:** โคมแสง Xenon Arc ของเครื่อง XPS-300 มีรังสี UV และความร้อนสูง คนเข้าไปนั่งข้างในไม่ได้ เราต้องดูว่าสาย USB ของเรายาวพอจะลอดออกมาข้างนอกไหม

#### คำถามที่ 3: แบบฟอร์มและขั้นตอนการขออนุญาต (Booking Procedure)
> *"สำหรับการใช้งานของนักศึกษาทำปริญญานิพนธ์ ต้องดาวน์โหลดแบบฟอร์มขอรับบริการตัวไหนครับ และต้องส่งให้อาจารย์ที่ปรึกษาเซ็นล่วงหน้าประมาณกี่วันครับ?"*
* **เหตุผล:** จะได้เตรียมเอกสารให้อาจารย์เซ็นให้เรียบร้อย ไม่ติดปัญหาเรื่องคิว

#### คำถามที่ 4: อัตราค่าบริการ (Service Fee)
> *"สำหรับโครงงานนักศึกษาภายใน สจล. มีโควตาขอยกเว้นค่าธรรมเนียม หรือใช้อัตราค่าบริการพิเศษสำหรับนักศึกษาไหมครับ?"*
* **เหตุผล:** ปกติศูนย์เครื่องมือ สจล. จะมีเรตนักศึกษาภายในที่ถูกมาก หรือมีโควตาสำหรับโครงงานปริญญานิพนธ์

---

### 🔹 ประโยคปิดท้าย (สร้างความประทับใจ):
> *"ถ้าพี่วิษาสะดวก ในช่วงบ่ายวัน... เดี๋ยวผมเดินแวะเข้าไปหาพี่ที่ตึก 55 ชั้น 3 เพื่อเอาบอร์ดไปให้ดูขนาดพื้นที่และรับแบบฟอร์มเอกสารก่อนได้ไหมครับ ขอบคุณพี่วิษามากๆ ครับ"*

---

## 🔬 3. ข้อมูลทางเทคนิคของเครื่อง Solar Light XPS-300 (สำหรับอ้างอิง):
* **สถานที่ตั้ง:** อาคาร 55 พรรษา เฉลิมพระเกียรติ ชั้น 3 คณะเทคโนโลยีการผลิตและนวัตกรรม สจล.
* **ชนิดเครื่องกำเนิดแสง:** 300W Xenon Arc Lamp
* **สเปกตรัมแสง:** สอดคล้องกับมาตรฐานแสงอาทิตย์ **AM 1.5G (Air Mass 1.5 Global)**
* **พื้นที่ตกกระทบของลำแสง (Beam Size):** เส้นผ่านศูนย์กลางประมาณ 2 – 4 นิ้ว (วางบอร์ดเซนเซอร์ขนาดฝ่ามือของเราได้พอดีทั้งแผ่น)
* **ช่วงความเข้มแสง:** ปรับได้รอบจุดมาตรฐาน **1 Sun ($1,000\text{ W/m}^2$ หรือ $100\text{ mW/cm}^2$)**
