tachin-r/Pyranometer_Over_engineering/Report_doc/image/perfboard_bottom_wiring.jpg

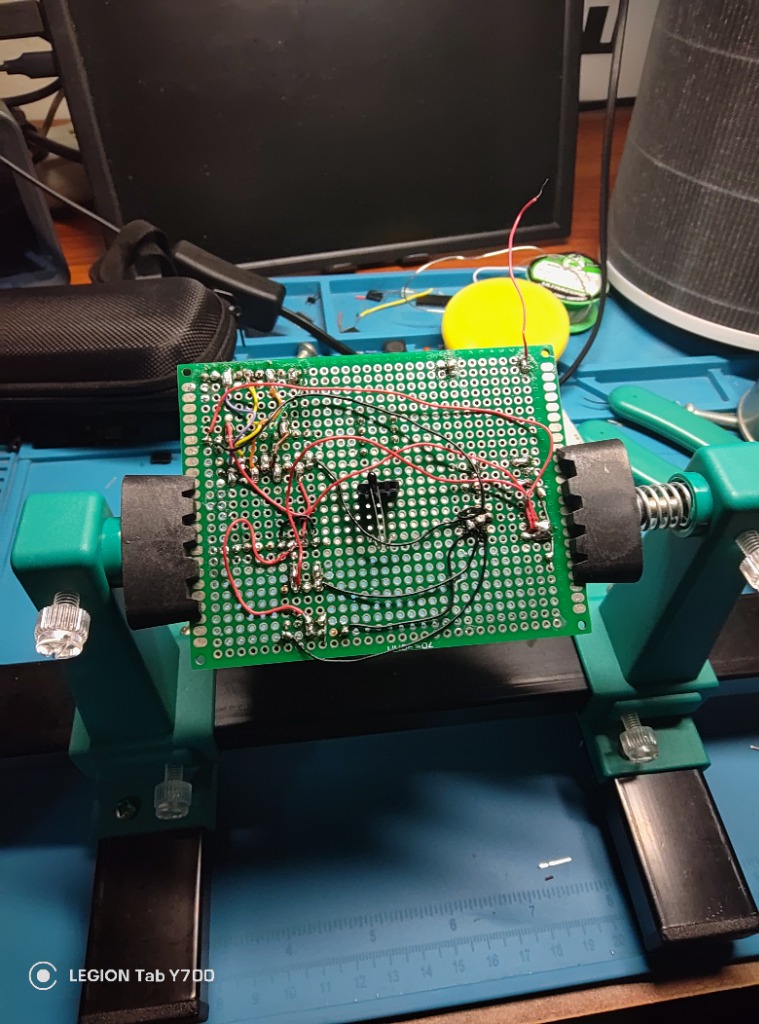
Report_doc/image/perfboard_bottom_wiring.jpg
