tachin-r/Pyranometer_Over_engineering/L1_Analog_BPW34/L1_Analog_BPW34.kicad_pcb

## KiCad design L1_Analog_BPW34/L1_Analog_BPW34.kicad_pcb (2026-11-11)

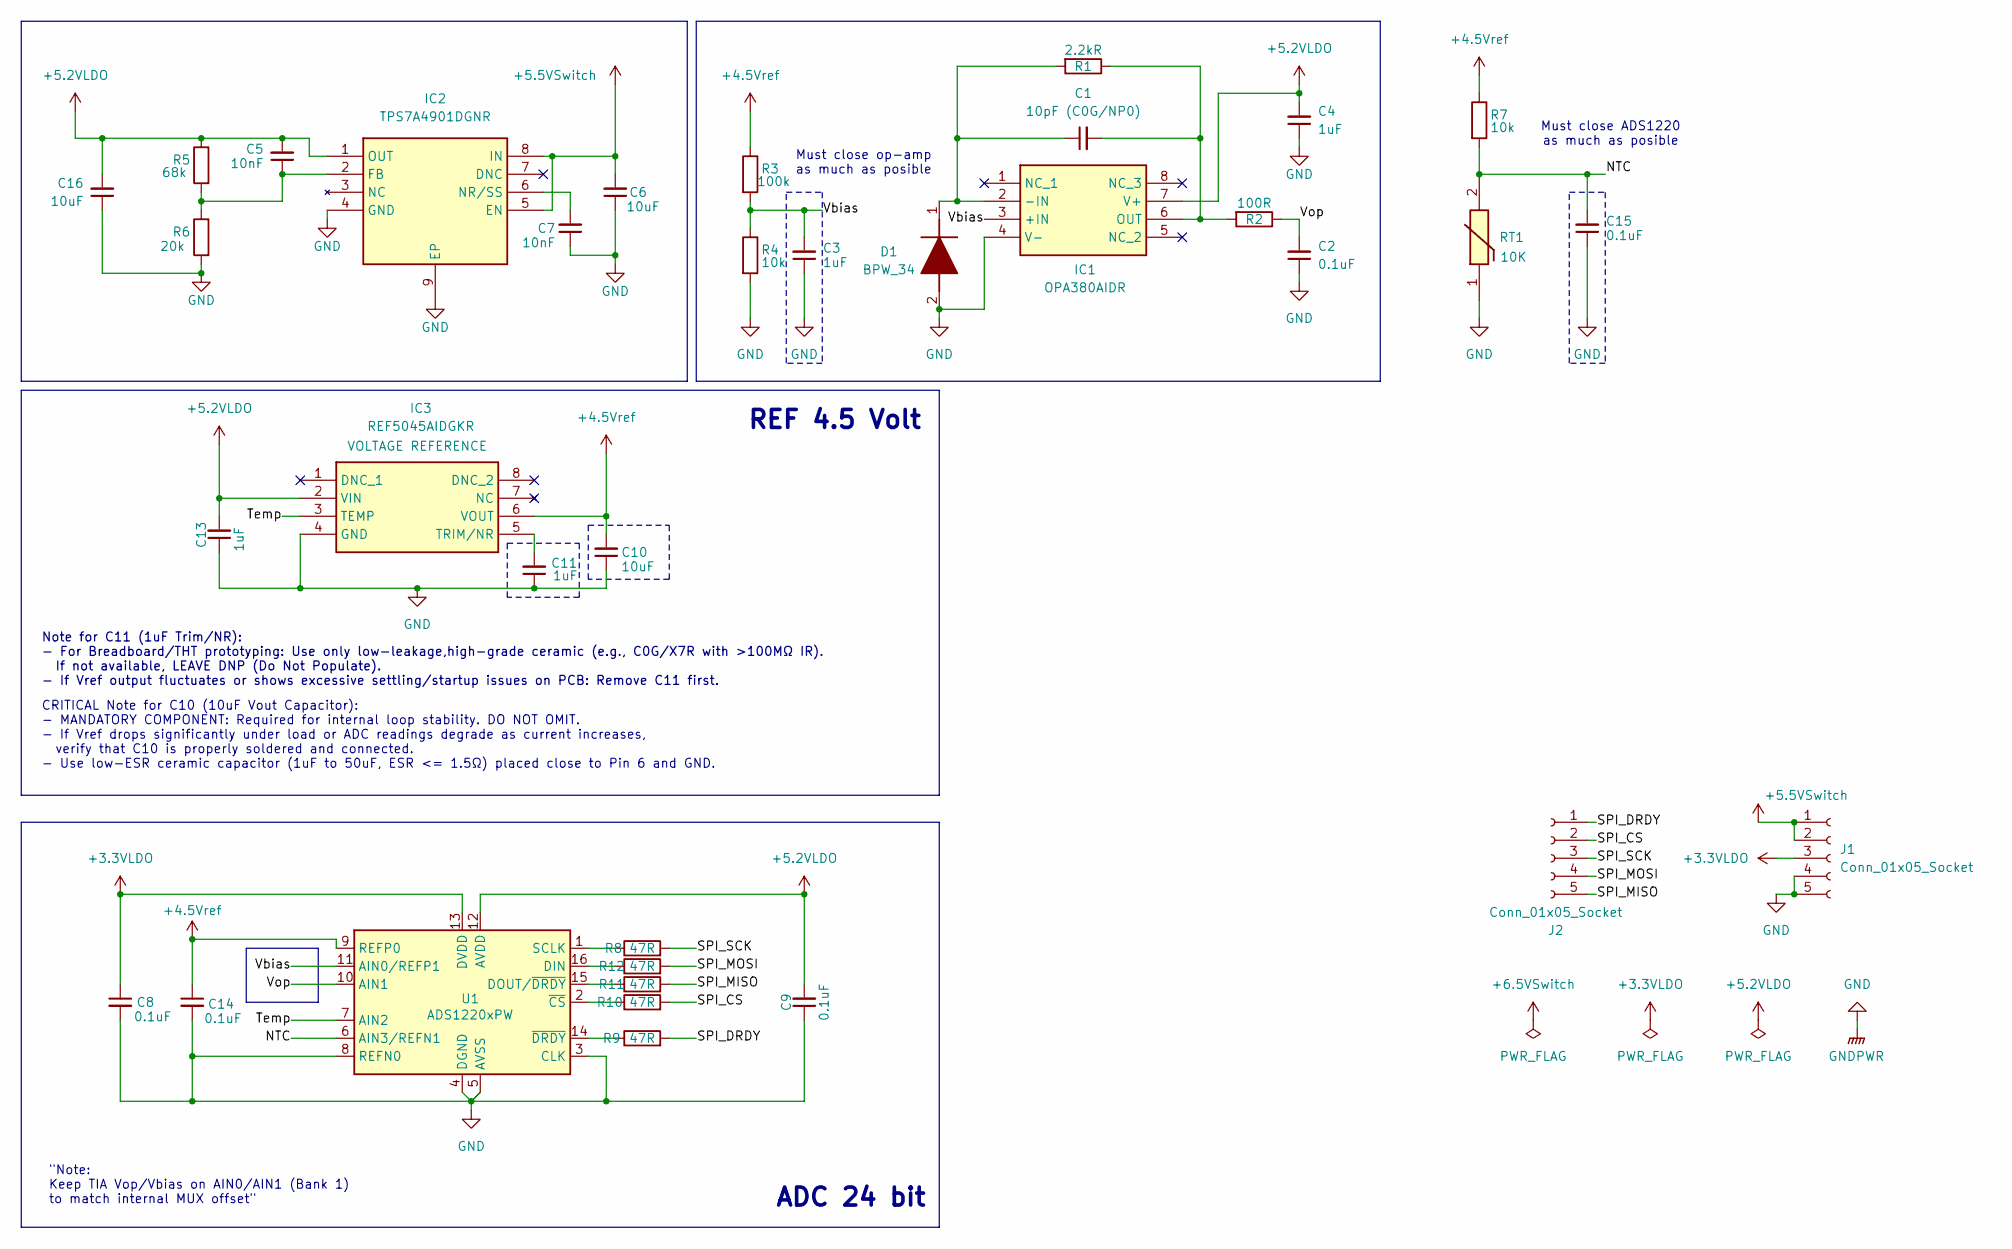
[picture p33: schematic L1_Analog_BPW34.kicad_sch]

Parts:
C1: 10pF (C0G/NP0); C_0805_2012Metric
C2, C8, C9, C14, C15: 0.1uF; C_0805_2012Metric
C3, C4, C11, C13: 1uF; C_0805_2012Metric
C5, C7: 10nF; C_0805_2012Metric
C6, C10, C16: 10uF; C_0805_2012Metric
D1: BPW_34; BPW34; Mouser Part Number 720-BPW34
IC1: OPA380AIDR; SOIC127P600X175-8N; Manufacturer_Part_Number OPA380AIDR; Mouser Part Number 595-OPA380AIDR
IC2: TPS7A4901DGNR; SOP65P490X110-9N; Manufacturer_Part_Number TPS7A4901DGNR; Mouser Part Number 595-TPS7A4901DGNR
IC3: REF5045AIDGKR; SOP65P490X110-8N; Mouser Part Number 595-REF5045AIDGKR
J1, J2: Conn_01x05_Socket; PinSocket_1x05_P2.54mm_Vertical
R1: 2.2kR; R_0805_2012Metric
R2: 100R; R_0805_2012Metric
R3: 100k; R_0805_2012Metric
R4, R7: 10k; R_0805_2012Metric
R5: 68k; R_0805_2012Metric
R6: 20k; R_0805_2012Metric
R8, R9, R10, R11, R12: 47R; R_0805_2012Metric
RT1: 10K; 103AT2; Manufacturer_Part_Number 103AT-2; Mouser Part Number 954-103AT-2
U1: ADS1220xPW; TSSOP-16_4.4x5mm_P0.65mm

Connections:
+3.3VLDO: C8.1, J1.3, U1.13 (DVDD)
+4.5Vref: C10.2, C14.1, IC3.6 (VOUT), R3.1, R7.1, U1.9 (REFP0)
+5.2VLDO: C4.2, C5.2, C9.2, C13.2, C16.2, IC1.7 (V+), IC2.1 (OUT), IC3.2 (VIN), R5.1, U1.12 (AVDD)
+5.5VSwitch: C6.2, IC2.5 (EN), IC2.8 (IN), J1.1, J1.2
/NTC: C15.2, R7.2, RT1.2, U1.6 (AIN3/REFN1)
/SPI_CS: J2.2, R10.2
/SPI_DRDY: J2.1, R9.2
/SPI_MISO: J2.5, R11.2
/SPI_MOSI: J2.4, R12.2
/SPI_SCK: J2.3, R8.2
/Temp: IC3.3 (TEMP), U1.7 (AIN2); also elsewhere on the board
/Vbias: C3.2, IC1.3 (+IN), R3.2, R4.1, U1.11 (AIN0/REFP1)
/Vop: C2.2, R2.1, U1.10 (AIN1)
GND: C2.1, C3.1, C4.1, C6.1, C7.1, C8.2, C9.1, C10.1, C11.1, C13.1, C14.2, C15.1, C16.1, D1.2 (A), IC1.4 (V-), IC2.4 (GND), IC2.9 (EP), IC3.4 (GND), J1.4, J1.5, R4.2, R6.2, RT1.1, U1.3 (CLK), U1.4 (DGND), U1.5 (AVSS), U1.8 (REFN0); also elsewhere on the board
unnamed: C1.1, D1.1 (K), IC1.2 (-IN), R1.2
unnamed: C1.2, IC1.6 (OUT), R1.1, R2.2
unnamed: C5.1, IC2.2 (FB), R5.2, R6.1
unnamed: C7.2, IC2.6 (NR/SS)
unnamed: C11.2, IC3.5 (TRIM/NR)
unnamed: R12.1, U1.16 (DIN)
unnamed: R11.1, U1.15 (DOUT/~DRDY)
unnamed: R8.1, U1.1 (SCLK)
unnamed: R10.1, U1.2 (~CS)
unnamed: R9.1, U1.14 (~DRDY)

Notes on the sheet:
Note for C11 (1uF Trim/NR): - For Breadboard/THT prototyping: Use only low-leakage,high-grade ceramic (e.g., C0G/X7R with >100MΩ IR). If not available, LEAVE DNP (Do Not Populate). - If Vref output fluctuates or shows excessive settling/startup issues on PCB: Remove C11 first.
"Note: Keep TIA Vop/Vbias on AIN0/AIN1 (Bank 1) to match internal MUX offset"
Must close ADS1220 as much as posible
Must close op-amp as much as posible
ADC 24 bit
CRITICAL Note for C10 (10uF Vout Capacitor): - MANDATORY COMPONENT: Required for internal loop stability. DO NOT OMIT. - If Vref drops significantly under load or ADC readings degrade as current increases, verify that C10 is properly soldered and connected. - Use low-ESR ceramic capacitor (1uF to 5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
REF 4.5 Volt

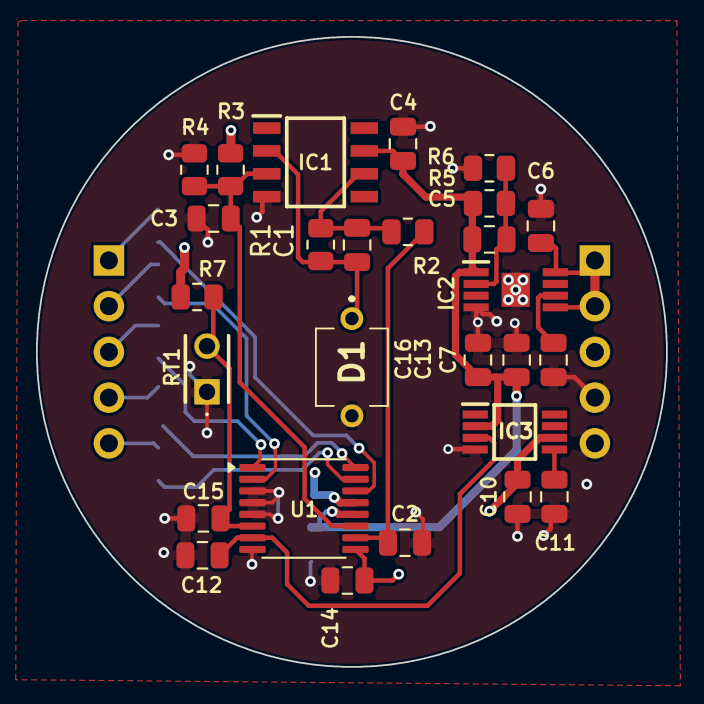
[picture p34: board L1_Analog_BPW34.kicad_pcb from above]

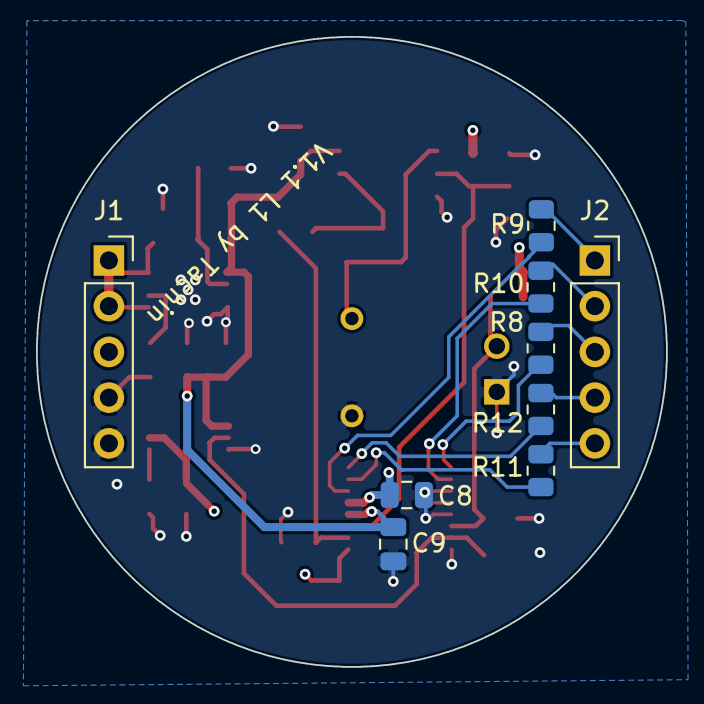
[picture p35: board L1_Analog_BPW34.kicad_pcb from below]

Board: 4 copper layers, 35.0 x 35.0 mm, 36 parts (9 on the bottom side), 24 nets.

Other parts of the board:
C12: 0.1uF; C_0805_2012Metric

Their connections:
/Temp: C12.2; also elsewhere on the board
GND: C12.1; also elsewhere on the board
