tachin-r/Pyranometer_Over_engineering/L2_MCU/L2_MCU.kicad_pcb

## KiCad design L2_MCU/L2_MCU.kicad_pcb (2026-10-15)

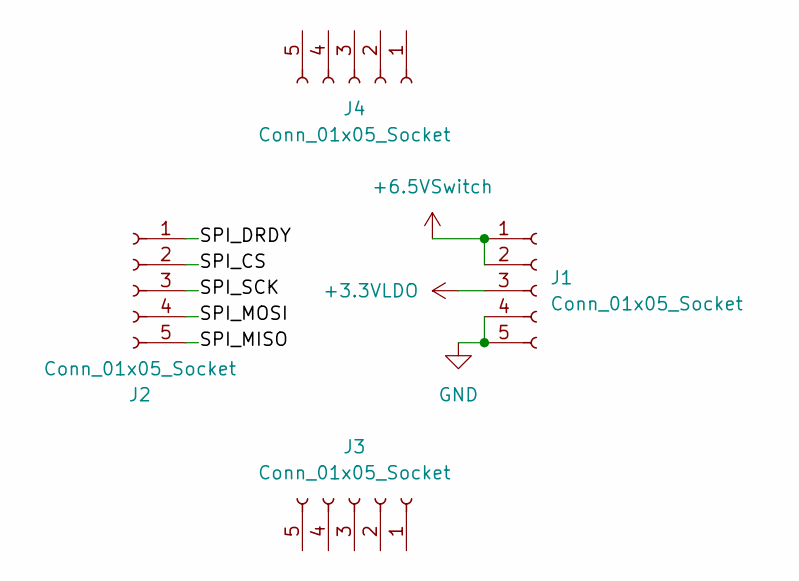
[picture p36: schematic L2_MCU.kicad_sch]

Parts:
J1, J2, J3, J4: Conn_01x05_Socket; PinHeader_1x05_P2.54mm_Vertical

Connections:
+3.3VLDO: J1.3
+6.5VSwitch: J1.1, J1.2
/SPI_CS: J2.2
/SPI_DRDY: J2.1
/SPI_MISO: J2.5
/SPI_MOSI: J2.4
/SPI_SCK: J2.3
GND: J1.4, J1.5

Board: 2 copper layers, 4 parts (2 on the bottom side), 2 nets, no tracks yet.
