tachin-r/Pyranometer_Over_engineering/(commit log)

2026-10-15 Initial commit: Pyranometer hardware project files with KiCanvas interactive links
    [L1_Analog-B_Cu.gbr, L1_Analog-B_Mask.gbr, L1_Analog-B_Paste.gbr, L1_Analog-B_Silkscreen.gbr, L1_Analog-Edge_Cuts.gbr, L1_Analog-F_Cu.gbr, L1_Analog-F_Mask.gbr, L1_Analog-F_Paste.gbr]
2026-10-16 Document prototyping notes: ADS1220 differential MUX grouping and REF5045 C10/C11 capacitor requirements
    [L1_Analog.kicad_sch]
2026-11-06 Update L1_Analog schematic component values and add Capstone 1 documentation & slide deck
    [L1_Analog.kicad_sch]
2026-11-06 Update L1_Analog PCB V1.1 to 100% DRC pass, add 3D renders to slides and report
    [L1_Analog.kicad_pcb, L1_Analog.kicad_sch]
2026-11-06 Create parallel project folder L1_Analog_BPW34 for BPW 34 sensor variant
    [L1_Analog.kicad_pcb, L1_Analog_BPW34.kicad_pcb, L1_Analog_BPW34.kicad_sch]
2026-11-07 Update L1_Analog_BPW34 PCB & schematic, add dual-variant 3D renders to slides and report
    [L1_Analog_BPW34.kicad_pcb, L1_Analog_BPW34.kicad_sch]
2026-11-11 docs: add comprehensive Photodiode and TIA theory with figures to report and slides
    [L1_Analog_BPW34.kicad_pcb, L1_Analog_BPW34.kicad_sch]
